afch/NixieClock/Schematic NCT318 v1.0.pdf

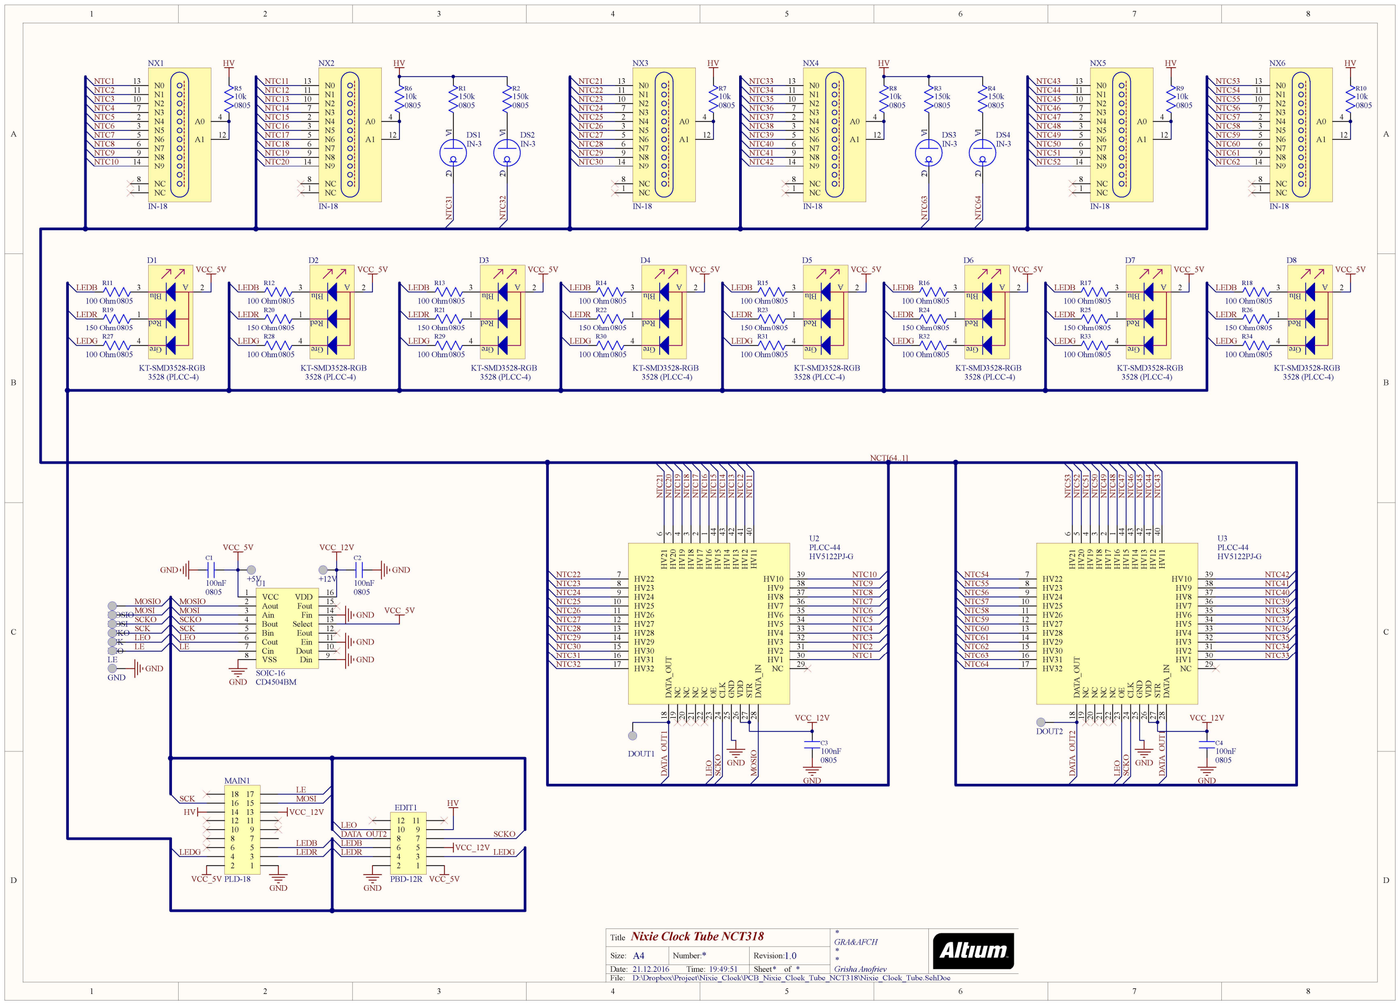
[picture p3: page 1]

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
GRA&AFCH
*
*
* | Grisha Anofriev

## Nixie Clock Tube NCT318

* | 1.0
21.12.2016 19:49:51
D:\Dropbox\Project\Nixie_Clock\PCB_Nixie_Clock_Tube_NCT318\Nixie_Clock_Tube.SchDoc

Title

Size: | Number:
Date:
File:

Revision:
Time: | Sheet | of

A4

IN-3 ¹ 2 A C | DS1
IN-3 ¹ 2 A C | DS2

150k
0805

R1
150k
0805

R2

100 Ohm0805

R11

150 Ohm0805

R19

100 Ohm0805

R27

IN-18

NC 1

N1 11
N2 10
N3 7
N4 2
N5 3
N6 5
N7 6
N8 9
N9 14

N0 13

A0 | 4
A1 | 12

NC 8

NX1

GND

VCC_5V

NTC1
NTC2
NTC3
NTC4
NTC5
NTC6
NTC7
NTC8
NTC9
NTC10

VCC_5V

LEDB

LEDR

LEDG | NTC³¹ | NTC³² IN-18

NC 1

N1 11
N2 10
N3 7
N4 2
N5 3
N6 5
N7 6
N8 9
N9 14

N0 13

A0 | 4
A1 | 12

NC 8

NX2

NTC11
NTC12
NTC13
NTC14
NTC15
NTC16
NTC17
NTC18
NTC19
NTC20

LEDG

LEDB
LEDR

IN-18

NC 1

N1 11
N2 10
N3 7
N4 2
N5 3
N6 5
N7 6
N8 9
N9 14

N0 13

A0 | 4
A1 | 12

NC 8

NX3

NTC21
NTC22
NTC23
NTC24
NTC25
NTC26
NTC27
NTC28
NTC29
NTC30

IN-18

NC 1

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

N0 13

A0 | 4
A1 | 12

NC 8

NX4

NTC33
NTC34
NTC35

NTC42

NTC36
NTC37
NTC38
NTC39
NTC40
NTC41

IN-18

NC 1

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

N0 13

A0 | 4
A1 | 12

NC 8

NX5

NTC43
NTC44
NTC45
NTC46
NTC47
NTC48
NTC49
NTC50
NTC51
NTC52

IN-18

NC 1

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

N0 13

A0 | 4
A1 | 12

NC 8

NX6

NTC53
NTC54
NTC55
NTC56
NTC57
NTC58
NTC59
NTC60
NTC61
NTC62

PLD-18

2 1

4 3

6 5

8 7

10 9

12 11

14

16

18

13

15

17

MAIN1

3528 (PLCC-4)

2

1

KT-SMD3528-RGB

3

4 | Red Blu Gre | A

D1

100 Ohm0805

R12

150 Ohm0805

R20

100 Ohm0805

R28

VCC_5V

LEDB

LEDR

LEDG

3528 (PLCC-4)

2

1

KT-SMD3528-RGB

3

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
HV30 15
HV31 16
HV32 17 | HV¹¹ ⁴⁰ HV¹² ⁴¹ HV¹³ ⁴² HV¹⁴ ⁴³ HV¹⁵ ⁴⁴ OE 23 CLK 24 GND 25 VDD 26 STR 27 DATA_IN 28 DATA_OUT 18 NC 19 NC 20 NC 21 NC 22
NC | 29 HV1 | 30 HV2 | 31 HV3 | 32 HV4 | 33 HV5 | 34 HV6 | 35 HV7 | 36 HV8 | 37 HV9 | 38 HV10 | 39

U3

DOUT1
GND
NTC3 | LEO | DATA_OUT¹ GND DATA_OUT²
