afch/NixieClock/Schematic_Tubes_Board_NCT414_v1.0.pdf

## Hour

## Hour

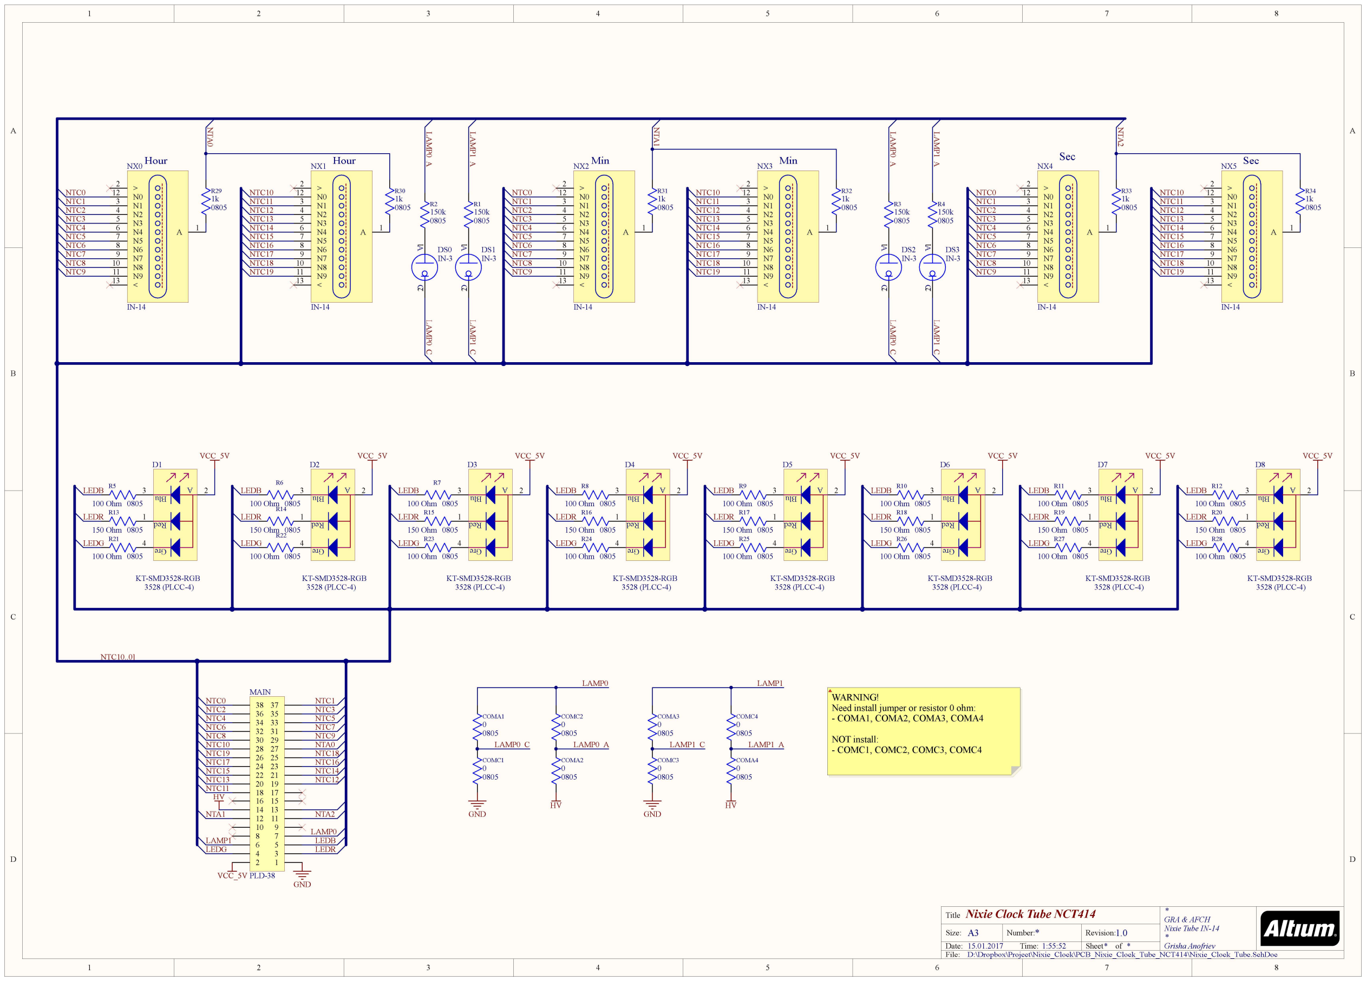
[picture p4: page 1]

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
GRA & AFCH
Nixie Tube IN-14
*
* | Grisha Anofriev

## Nixie Clock Tube NCT414

* | 1.0
15.01.2017 1:55:52
D:\Dropbox\Project\Nixie_Clock\PCB_Nixie_Clock_Tube_NCT414\Nixie_Clock_Tube.SchDoc

Title

Size: | Number:
Date:
File:

Revision:
Time: | Sheet | of

A3

IN-3 ¹ 2 A C | DS1
IN-3 ¹ 2 A C | DS0

150k
0805

R1
150k
0805

R2

GND

VCC_5V

NTC1
NTC2
NTC3
NTC4
NTC5
NTC6
NTC7
NTC8
NTC9 | NTA0 | LAMP0_A | LAMP1_A

VCC_5V

LEDR

LEDG

NTC2
NTC4
NTC6
NTC8
NTC0 | NTC1 NTC3 NTC5 NTC7 NTC9 NTA0

NTA1

LAMP1
LEDG

NTA2

LEDB
LEDR

LAMP0

NTC10

IN-14

>

2

N1 3
N2 4
N3 5
N4 6
N5 7
N6 8
N7 9
N8 10
N9 11

N0 12

A

1

<

13

NX0

NTC11
NTC12
NTC13
NTC14
NTC15
NTC16
NTC17
NTC18
NTC19 | NTA1

IN-14

>

2

N1 3
N2 4
N3 5
N4 6
N5 7
N6 8
N7 9
N8 10
N9 11

N0 12

A

1

<

13

NX1

NTC10

IN-3 ¹ 2 A C | DS3
IN-3 ¹ 2 A C | DS2

150k
0805

R4
150k
0805
R3 LAMP0_A | LAMP1_AMin

IN-14

>

2

N1 3
N2 4
N3 5
N4 6
N5 7
N6 8
N7 9
N8 10
N9 11

N0 12

A

1

<

13

NX2 | Min

IN-14

>

2

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

N0 12

A

1

<

13

NX3

## Sec

IN-14

>

2

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

N0 12

A

1

<

13

NX4 | Sec

IN-14

>

2

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

N0 12

A

1

<

13

NX5

100 Ohm 0805

R5

150 Ohm 0805

R13

100 Ohm 0805

R21

VCC_5V

LEDR

LEDG

100 Ohm 0805

R8

150 Ohm 0805

R16

100 Ohm 0805

R24

VCC_5V

LEDR

LEDG

100 Ohm 0805

R7

150 Ohm 0805

R15

100 Ohm 0805

R23

VCC_5V

LEDR

LEDG

100 Ohm 0805

R10

150 Ohm 0805

R18

100 Ohm 0805

R26

VCC_5V

LEDR

LEDG

100 Ohm 0805

R9

150 Ohm 0805

R17

100 Ohm 0805

R25

VCC_5V

LEDR

LEDG

100 Ohm 0805

R12

150 Ohm 0805

R20

100 Ohm 0805

R28

VCC_5V

LEDR

LEDG

100 Ohm 0805

R11

150 Ohm 0805

R19

100 Ohm 0805

R27

VCC_5V

LEDR

LEDG

NTC10..0] | NTA2
LEDB | LEDB | LEDB | LEDB | LEDB | LEDB | LEDB | LEDB
| 100 Ohm 0805

R6

150 Ohm 0805

R14

100 Ohm 0805

R22

2 1

4 3

6 5

8 7

10 9

12 11

14 13

16 15

18 17

20 19

22 21

24 23

26 25

28 27

30 29

32 31

34 33

36 35

38 37

PLD-38

MAIN

NTC19
NTC17
NTC15
NTC13
NTC11

NTC12

NTC14

NTC16

NTC18

1k
0805

R29
1k
0805

R30
1k
0805

R31
1k
0805

R32
1k
0805

R33
1k
0805
NTC0 | R34
NTC1
NTC2
NTC3
NTC4
NTC5
NTC6
NTC7
NTC8
NTC9

NTC0

3528 (PLCC-4)

2

1

KT-SMD3528-RGB

3

4 | Red Blu Gre | A

D1

3528 (PLCC-4)

2

1

KT-SMD3528-RGB

3

4 | Red Blu Gre | A

D2

3528 (PLCC-4)

2

1

KT-SMD3528-RGB

3

4 | Red Blu Gre | A

D3

3528 (PLCC-4)

2

1

KT-SMD3528-RGB

3

4 | Red Blu Gre | A

D4

3528 (PLCC-4)

2

1

KT-SMD3528-RGB

3

4 | Red Blu Gre | A

D5

3528 (PLCC-4)

2

1

KT-SMD3528-RGB

3

4 | Red Blu Gre | A

D6

3528 (PLCC-4)

2

1

KT-SMD3528-RGB

3

4 | Red Blu Gre | A

D7

3528 (PLCC-4)

2

1

KT-SMD3528-RGB

3

4 | Red Blu Gre | A

D8

NTC11
NTC12
NTC13
NTC14
NTC15
NTC16
NTC17
NTC18
NTC19

NTC10
NTC11
NTC12
NTC13
NTC14
NTC15
NTC16
NTC17
NTC18
NTC19

NTC10
NTC1
NTC2
NTC3
NTC4
NTC5
NTC6
NTC7
NTC8
NTC9

NTC0

HV

0
0805

COMA2

0
0805

COMC2

0
0805

COMC1

0
0805

COMA1

LAMP0_C | LAMP0_A

HV

LAMP0

GND

0
0805

COMA4

0
0805

COMC4

0
0805

COMC3

0
0805

COMA3

LAMP1_C | LAMP1_A

HV

LAMP1

GND LAMP0_C | LAMP1_C | LAMP0_C | LAMP1_C

### WARNING! Need install jumper or resistor 0 ohm: - COMA1, COMA2, COMA3, COMA4

### NOT install: - COMC1, COMC2, COMC3, COMC4
