afch/NixieClock/Schemes/Scheme Tubes Board - NCT482 v1.0.pdf

## Hour

## Hour

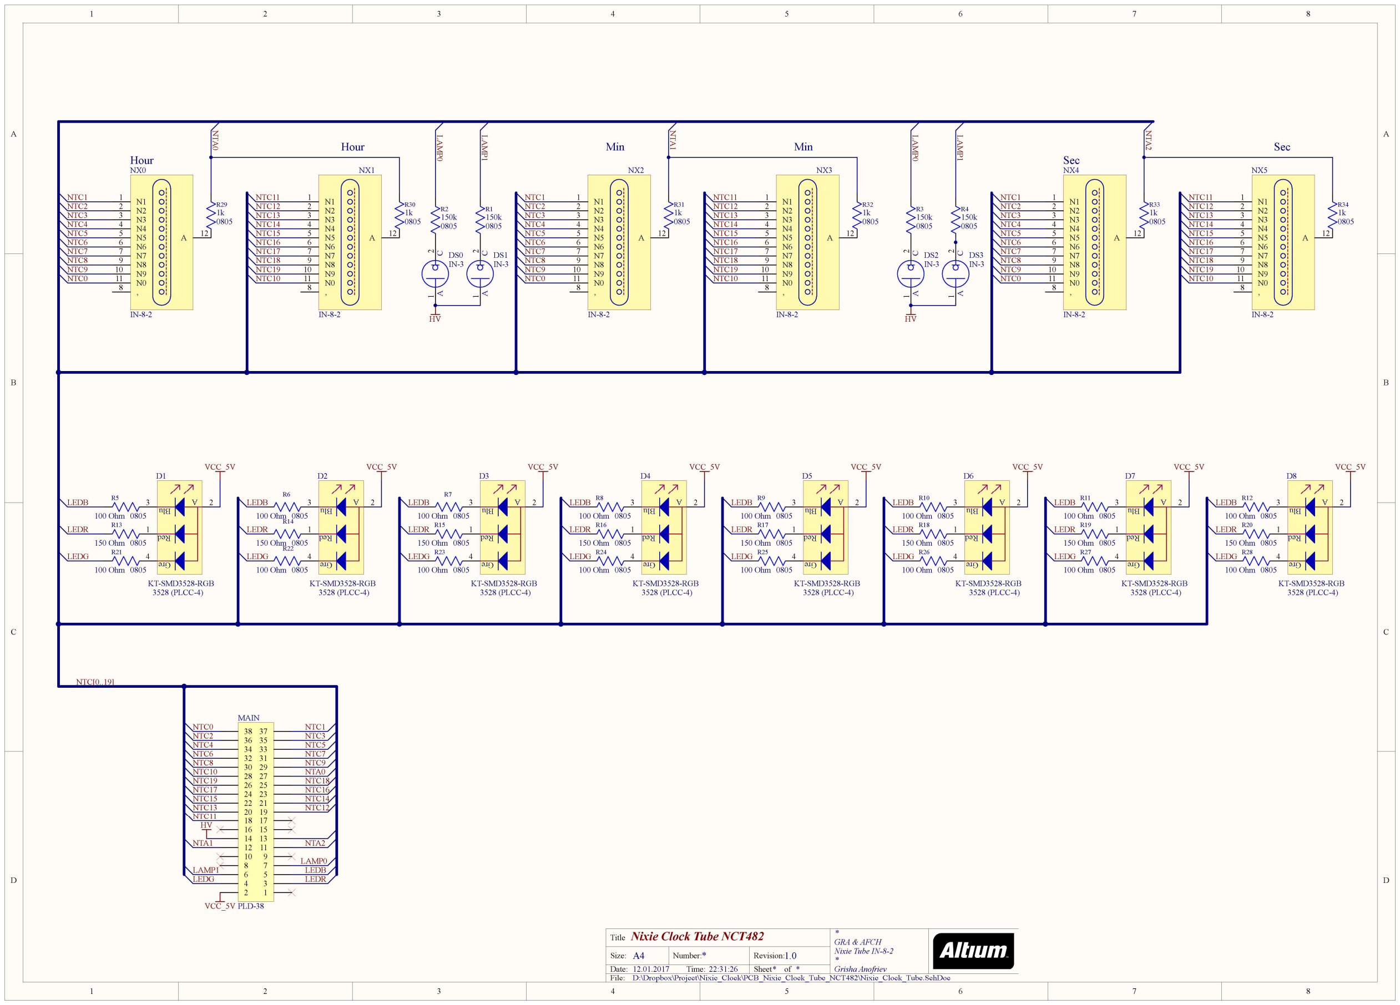
[picture p6: page 1]

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
GRA & AFCH
Nixie Tube IN-8-2
*
* | Grisha Anofriev

## Nixie Clock Tube NCT482

* | 1.0
12.01.2017 22:31:26
D:\Dropbox\Project\Nixie_Clock\PCB_Nixie_Clock_Tube_NCT482\Nixie_Clock_Tube.SchDoc

Title

Size: | Number:
Date:
File:

Revision:
Time: | Sheet | of

A4

IN-3 1 2 A CDS1

IN-3 1 2 A CDS0

150k
0805

R1
150k
0805

R2

NTC1
NTC2
NTC3
NTC4
NTC5
NTC6
NTC7
NTC8
NTC9
NTC0 | NTA0 | LAMP0 | LAMP1

VCC_5V

LEDR

LEDG

NTC11
NTC12
NTC13
NTC14
NTC15
NTC16
NTC17
NTC18
NTC19 | NTA1

IN-3 1 2 A CDS3

IN-3 1 2 A CDS2

150k
0805

R4
150k
0805

R3

NTC1
NTC2
NTC3
NTC4
NTC5
NTC6
NTC7
NTC8
NTC9
NTC0 | LAMP0 | LAMP1 Min | Min

NTC1
NTC2
NTC3
NTC4
NTC5
NTC6
NTC7
NTC8
NTC9
NTC0

## Sec

## Sec

100 Ohm 0805

R5

150 Ohm 0805

R13

100 Ohm 0805

R21

VCC_5V

LEDR

LEDG

100 Ohm 0805

R8

150 Ohm 0805

R16

100 Ohm 0805

R24

VCC_5V

LEDR

LEDG

100 Ohm 0805

R7

150 Ohm 0805

R15

100 Ohm 0805

R23

VCC_5V

LEDR

LEDG

100 Ohm 0805

R10

150 Ohm 0805

R18

100 Ohm 0805

R26

VCC_5V

LEDR

LEDG

100 Ohm 0805

R9

150 Ohm 0805

R17

100 Ohm 0805

R25

VCC_5V

LEDR

LEDG

100 Ohm 0805

R12

150 Ohm 0805

R20

100 Ohm 0805

R28

VCC_5V

LEDR

LEDG

100 Ohm 0805

R11

150 Ohm 0805

R19

100 Ohm 0805

R27

VCC_5V

LEDR

LEDG | NTA2
LEDB | LEDB | LEDB | LEDB | LEDB | LEDB | LEDB | LEDB
| 100 Ohm 0805

R6

150 Ohm 0805

R14

100 Ohm 0805

R22

3528 (PLCC-4)

2

1

KT-SMD3528-RGB

3

4 | Red Blu Gre | A

D1

3528 (PLCC-4)

2

1

KT-SMD3528-RGB

3

4 | Red Blu Gre | A

D2

3528 (PLCC-4)

2

1

KT-SMD3528-RGB

3

4 | Red Blu Gre | A

D3

3528 (PLCC-4)

2

1

KT-SMD3528-RGB

3

4 | Red Blu Gre | A

D4

3528 (PLCC-4)

2

1

KT-SMD3528-RGB

3

4 | Red Blu Gre | A

D8

3528 (PLCC-4)

2

1

KT-SMD3528-RGB

3

4 | Red Blu Gre | A

D7

3528 (PLCC-4)

2

1

KT-SMD3528-RGB

3

4 | Red Blu Gre | A

D6

3528 (PLCC-4)

2

1

KT-SMD3528-RGB

3

4 | Red Blu Gre | A

D5

N1 1
N2 2
N3 3
N4 4
N5 5
N6 6
N7 7
N8 9
N9 10
N0 11

A

12

IN-8-2

,

8

NX0

N1 1
N2 2
N3 3
N4 4
N5 5
N6 6
N7 7
N8 9
N9 10
N0 11

A

12

IN-8-2

,

8

NX5

N1 1
N2 2
N3 3
N4 4
N5 5
N6 6
N7 7
N8 9
N9 10
N0 11

A

12

IN-8-2

,

8

NX4

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

A

12

IN-8-2

,

8

NX3

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

A

12

IN-8-2

,

8

NX2

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

A

12

IN-8-2

,

8

NX1

NTC10

VCC_5V

NTC2
NTC4
NTC6
NTC8
NTC0 | NTC1 NTC3 NTC5 NTC7 NTC9 NTA0

NTA1

LAMP1
LEDG

NTA2

LEDB
LEDR

LAMP0

NTC10
NTC19
NTC17
NTC15
NTC13
NTC11

NTC12

NTC14

NTC16

NTC18

HV

1k
0805

R34
1k
0805

R33
1k
0805

R32
1k
0805

R31
1k
0805

R30
1k
0805

R29

HV | HV

NTC11
NTC12
NTC13
NTC14
NTC15
NTC16
NTC17
NTC18
NTC19
NTC10

NTC11
NTC12
NTC13
NTC14
NTC15
NTC16
NTC17
NTC18
NTC19
NTC10

2 1

4 3

6 5

8 7

10 9

12 11

14 13

16 15

18 17

20 19

22 21

24 23

26 25

28 27

30 29

32 31

34 33

36 35

38 37

PLD-38

MAIN

NTC[0..19]
