afch/NixieClock/Schemes/Scheme Nixie Clock Main Board MCU - NCM107 v1.1.pdf

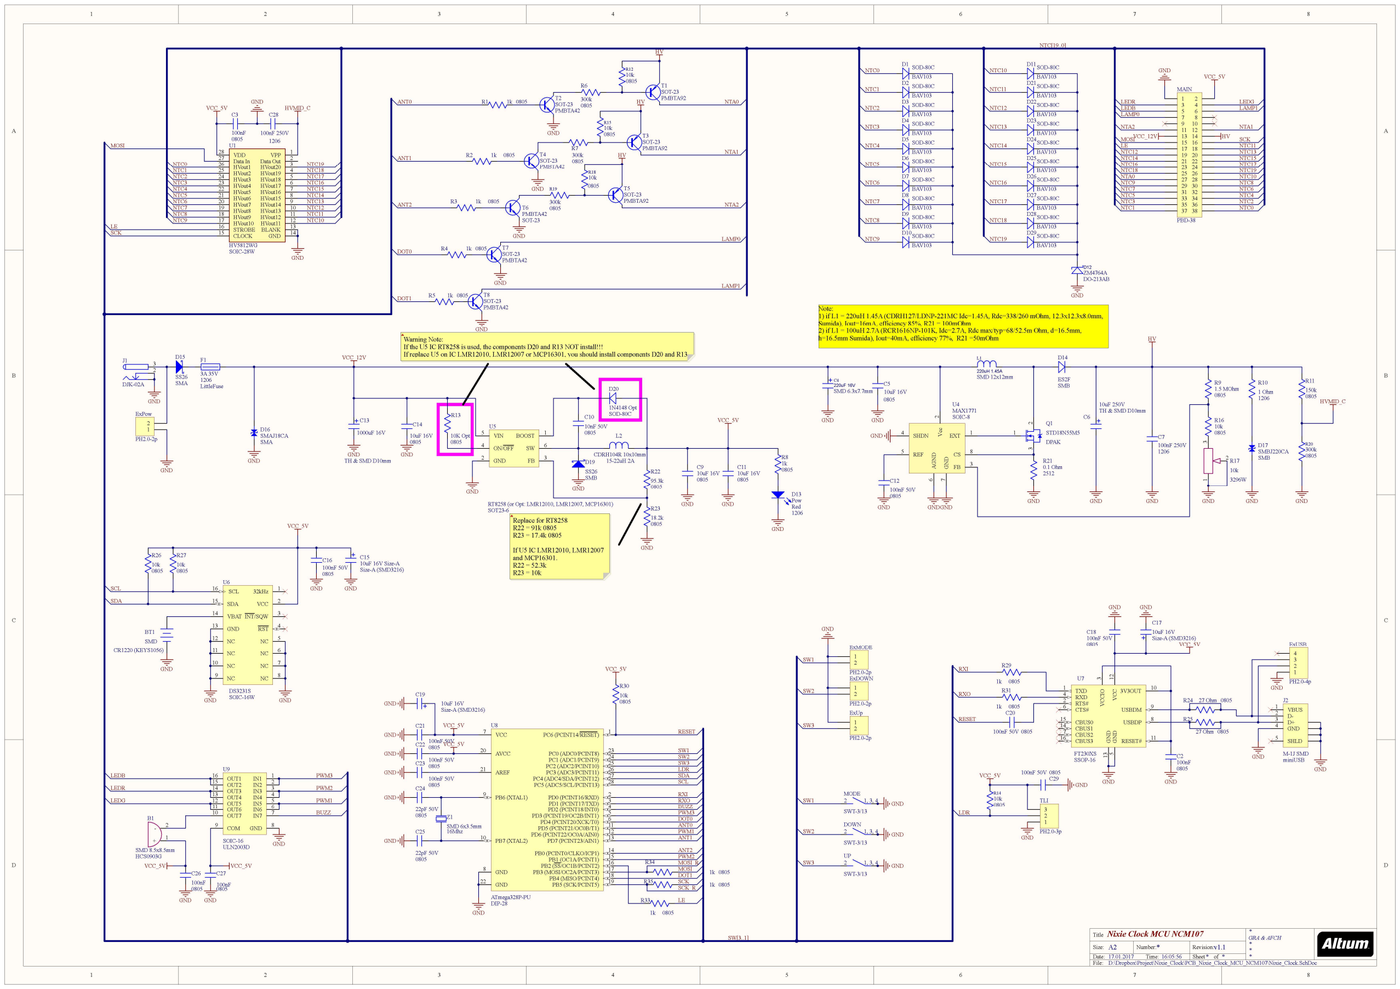
[picture p7: page 1]

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
GRA & AFCH
*
*
* | *

## Nixie Clock MCU NCM107

* | v1.1
17.01.2017 16:05:56
D:\Dropbox\Project\Nixie_Clock\PCB_Nixie_Clock_MCU_NCM107\Nixie_Clock.SchDoc

Title

Size: | Number:
Date:
File:

Revision:
Time: | Sheet | of

A2

Pow
Red
1206

D13

1k
0805

R8

GND

VCC_5V

GND

GND

95.3k
0805

R22

18.2k
0805

R23

GND

10nF 50V
0805

C10

GND

SS26
SMB

D19

GND

GND

10uF 16V
0805

C14

GND | GND

SOIC-8

SHDN 4

REF 5 | AGND

### 6 GND

7

FB | 3
CS | 8
EXT | 1 Vcc 2

MAX1771

U4

GNDGND

100nF 50V
0805

C12

GND

GND

ES2F
SMB

D14

100nF 250V
1206

C7

GND | GND

### 1.5 MOhm

0805

R9

10k
0805

R16

GND | GND

10uF 16V
0805

C5

GND

HVMID_C 1206

### 1 Ohm

R10

GND

300k
0805

R7

R1 | 1k 0805
R2 | 1k 0805
R3 | 1k 0805
R4 | 1k 0805
R5 | 1k 0805

100nF
0805

C3

SOIC-16
ULN2003D
IN1 | 1
IN2 | 2
IN3 | 3
IN4 | 4
IN5 | 5
IN6 | 6
IN7 | 7

OUT1 16

OUT3 14
OUT4 13
OUT5 12
OUT6 11
OUT7 10

OUT2 15

COM 9 | GND | 8

U9

SMD
CR1220 (KEYS1056)

BT1

M-1J SMD

VBUS 1
D- 2
D+ 3
GND 4

SHLD 5

miniUSB

J2

2 1, 3, 4

SWT-3/13

MODE

2 1, 3, 4

SWT-3/13

DOWN

2 1, 3, 4

SWT-3/13

UP

10k
0805

R26
10k
0805

R27

100nF 50V
0805

C16

100nF
0805

C27

100nF 50V
0805

C18

100nF
0805

C26

SMD 6x3.5mm
16Mhz

Z1

22pF 50V
0805

C24

22pF 50V
0805

C25

100nF 50V
0805

C21

100nF 50V
0805

C22

100nF 50V
0805

C23

10uF 16V
Size-A (SMD3216)
C19 | 10k
| 0805

R30

R24 27 Ohm 0805

### 27 Ohm 0805

R25

1k 0805

R29

1k 0805

R31

100nF 50V 0805

C20

10uF 16V
Size-A (SMD3216)

C17

VCC_5V

GND | GND

GND

GND

GND | GND
VCC_5V | VCC_5V

VCC_5V

VCC_5V

VCC_5V

VCC_5V

ATmega328P-PU
DIP-28
PC6 (PCINT14/RESET) | 1
PD0 (PCINT16/RXD) | 2
PD1 (PCINT17/TXD) | 3
PD2 (PCINT18/INT0) | 4
PD3 (PCINT19/OC2B/INT1) | 5
PD4 (PCINT20/XCK/T0) | 6

VCC 7

GND 8

PB6 (XTAL1) 9

PB7 (XTAL2) 10

PD5 (PCINT21/OC0B/T1) | 11
PD6 (PCINT22/OC0A/AIN0) | 12
PD7 (PCINT23/AIN1) | 13
PB0 (PCINT0/CLKO/ICP1) | 14
PB1 (OC1A/PCINT1) | 15
PB2 (SS/OC1B/PCINT2) | 16
PB3 (MOSI/OC2A/PCINT3) | 17
PB4 (MISO/PCINT4) | 18
PB5 (SCK/PCINT5) | 19

AVCC 20

AREF 21

GND 22

PC0 (ADC0/PCINT8) | 23
PC1 (ADC1/PCINT9) | 24
PC2 (ADC2/PCINT10) | 25
PC3 (ADC3/PCINT11) | 26
PC4 (ADC4/SDA/PCINT12) | 27
PC5 (ADC5/SCL/PCINT13) | 28

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
GND | GND

GND

GND

GND

GND

GND

GND

HVMID_C

GND

SCK

LE

MOSI

NTC6

NTC5

NTC4

NTC3

NTC2

NTC1

NTC0

NTA0

NTA1

NTA2

LAMP0

LAMP1

NTC0

NTC1

NTC2

NTC3

NTC4

NTC5

NTC6

NTC7

NTC8

NTC9

LEDR
LEDB
LAMP0

NTA2

NTA0
NTC9
NTC7
NTC5
NTC3
NTC1 | NTC0 NTC2

NTC4

NTC6

NTC8

NTC10

NTA1

LAMP1

LEDG

GND
VCC_5V

SW1

SW2

SW3

RXI

RXO

RESET

RESET

SW1
SW2

SDA
SCL

RXI
RXO
BUZZ
PWM3

ANT2

PWM1

LE

ANT0

PWM2

MOSI

SCK

PWM3

PWM2

PWM1

BUZZ

LEDB

LEDR

LEDG

SCL

SDA

NTC[19..0]

SW[3..1]

3296W

10k ³ 1

### 2 R17

10uF 16V Size-A
Size-A (SMD3216)

C15

GND

GND

GND

150k
0805

R11

SMBJ220CA
SMB

D17

1000uF 16V

TH & SMD D10mm

C13

10uF 250V
TH & SMD D10mm
C6

GND

100nF 250V
1206

C28

1k 0805

R33

1k 0805

R34

1k 0805 R35

MOSI_R

SCK_R

10uF 16V
0805

C9
10uF 16V
0805

C11

10K Opt
0805

R13

CDRH104R 10x10mm
15-22uH 2A

L2

1N4148 Opt
SOD-80C

D20

SW1

SW2

SW3

SMD 8.5x8.5mm
HCS0903G

+

1

2

B1

GND

FB | 3
VIN 5 | BOOST | 1

GND 2

SW 6 ON/OFF 4

RT8258 (or Opt: LMR12010, LMR12007, MCP16301) SOT23-6

U5

3A 35V
1206
LittleFuse

F1

### Note:

1) if L1 = 220uH 1.45A (CDRH127/LDNP-221MC Idc=1.45А, Rdc=338/260 mOhm, 12.3x12.3x8.0mm,

### Sumida), Iout=16mA, efficiency 85%, R21 = 100mOhm

2) if L1 = 100uH 2.7A (RCR1616NP-101K, Idc=2.7A, Rdc max/typ=68/52.5m Ohm, d=16.5mm,
h=16.5mm Sumida), Iout=40mA, efficiency 77%, R21 =50mOhm | VCC ¹² VCCIO

3
3V3OUT 10 GND

# 5 GND 13

USBDM | 9
USBDP | 8
RESET# | 11

TXD 1
RXD 4
RTS# 2
CTS# 6

CBUS0 15
CBUS1 14
CBUS2 7
CBUS3 16

FT230XS
SSOP-16

U7

100nF
0805

C2

GND

HV5812WG
SOIC-28W
VPP | 1
Data Out | 2
HVout20 | 3
HVout19 | 4
HVout18 | 5
HVout17 | 6
HVout16 | 7
HVout15 | 8
HVout14 | 9
HVout13 | 10
HVout12 | 11
HVout11 | 12
BLANK | 13
GND | 14 CLOCK 15 | STROBE 16 | HVout10 17 | HVout9 18 | HVout8 19 | HVout7 20 | HVout6 21 | HVout5 22 | HVout4 23 | HVout3 24

VDD 28
Data In 27
HVout1 26
HVout2 25

U1

SOD-80C
BAV103

D2

SS26
SMA

D15

SOD-80C
BAV103

D4

SOD-80C
BAV103

D6

SOD-80C
BAV103

D8

SOD-80C
BAV103

D10

SOD-80C
BAV103

D21

SOD-80C
BAV103

D23

SOD-80C
BAV103

D25

SOD-80C
BAV103

D27

SOD-80C
BAV103

D29

NTC10

NTC11

NTC12

NTC13

NTC14

NTC15

NTC16

NTC17

NTC18

NTC19

SOD-80C
BAV103

D1

SOD-80C
BAV103

D3

SOD-80C
BAV103

D5

SOD-80C
BAV103

D7

SOD-80C
BAV103

D9

SOD-80C
BAV103

D11

SOD-80C
BAV103

D22

SOD-80C
BAV103

D24

SOD-80C
BAV103

D26

SOD-80C
BAV103

D28

NTC11
NTC12 | NTC13
NTC14 | NTC15
NTC16 | NTC17
NTC18 | NTC19

NTC7
NTC8
NTC9

NTC19
NTC18
NTC17
NTC16
NTC15
NTC14
NTC13
NTC12
NTC11
NTC10

PH2.0-2p

1
2

ExUp

PH2.0-2p

1
2

ExDOWN

PH2.0-2p

1
2

ExMODE

GND

PH2.0-4p

1

2

3

4

ExUSB

PH2.0-2p

1

2

ExPow

GND

VCC_5V

HV

VCC_12V

VCC_12V MOSI
LE

SCK

220uF 16V
SMD 6.3x7.7mm

C4

ANT1

PH2.0-3p

1

2

3

TLI

GND

10k
0805

R14

VCC_5V

SW3
LDR

LDR

100nF 50V 0805
C29
GND
32kHz | 1
VCC | 2
INT/SQW | 3
RST | 4 GND 13

VBAT 14

SDA 15

SCL 16

NC | 5
NC | 6
NC | 7
NC | 8 NC 9

NC 10

NC 11

NC 12

DS3231S
SOIC-16W

U6

GND

SMAJ18CA
SMA

D16

DOT1

DOT0

GND

SOT-23
PMBTA42

T8

SOT-23
PMBTA42

T7

SOT-23

PMBTA42

T6

SOT-23
PMBTA42

T4

SOT-23
PMBTA42

T2

SOT-23
PMBTA92

T1

SOT-23
PMBTA92

T3

SOT-23
PMBTA92

T5

GND

GND

300k
0805

R6

GND

GND

300k
0805

R19

10k
0805

R12

10k
0805

R15

10k
0805

R18

HV

HV

ANT0

ANT1

ANT2

DOT0

DOT1

ZM4764A
DO-213AB

D12

### 0.1 Ohm

2512

R21

STD18N55M5

DPAK ²
1 3

Q1

220uH 1.45A
SMD 12x12mm

L1

1 2
3 4
5 6
7 8
9 10
11 12
13 14
15 16
17 18
19 20
21 22
23 24
25 26
27 28
29 30
31 32
33 34
35 36
37 38
PBD-38

MAIN

3

1

2

DJK-02A

J1

300k
0805

R20

### Replace for RT8258

R22 = 91k 0805
R23 = 17.4k 0805

### If U5 IC LMR12010, LMR12007

and MCP16301.
R22 = 52.3k
R23 = 10k

### Warning Note: If the U5 IC RT8258 is used, the components D20 and R13 NOT install!!!

If replace U5 on IC LMR12010, LMR12007 or MCP16301, you should install components D20 and R13
