afch/NixieClock/Firmwares/MCU Board NCM109 v1.x for Tubes board NCT3xx (8 tubes)_1K/Source Code/CountDownTimerNCT818/Readme.txt

Задумка такая:
Формат: hh:hh:mm:ss
Mode - длинное нажатие вход в режим установки, короткое нажатие переход на следующию цифру, дошли дальше послендей - выход.
Mode - короткие нажатия start/stop
UP/DOWN - в режиме установки увеличивает по одной цифре (каждую индивидуально)

Каждая цифра свой элемент массива
