afch/NixieClock/Schemes/Previous Versions/Scheme Nixie Clock Main Board MCU - NCM105 v1.6.pdf

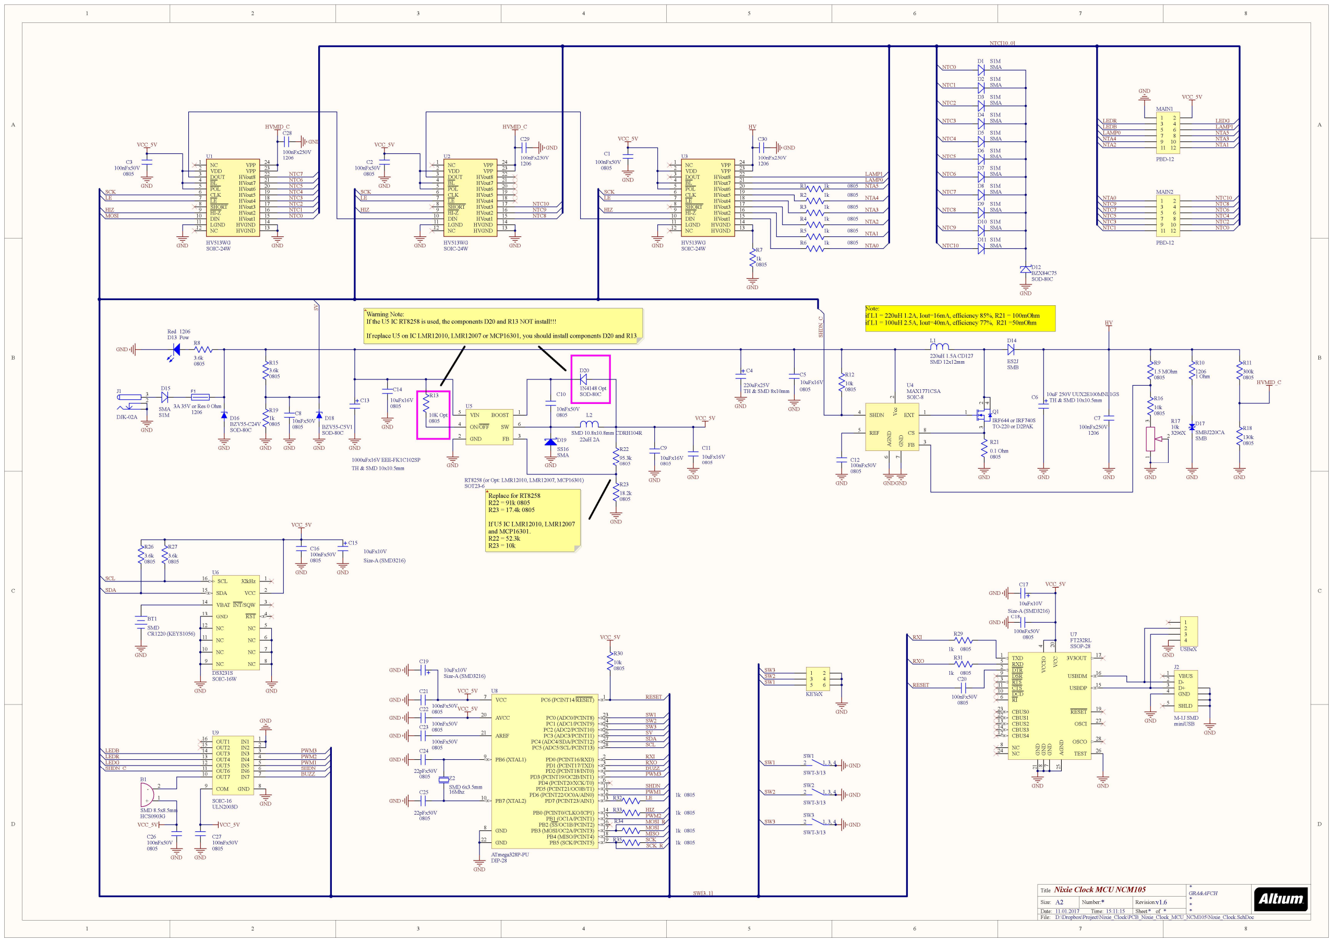
[picture p8: page 1]

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
GRA&AFCH
*
*
* | *

## Nixie Clock MCU NCM105

* | v1.6
11.01.2017 15:11:15
D:\Dropbox\Project\Nixie_Clock\PCB_Nixie_Clock_MCU_NCM105\Nixie_Clock.SchDoc

Title

Size: | Number:
Date:
File:

Revision:
Time: | Sheet | of

A2

3

1

2

DJK-02A

J1

SMA
S1M

D15

Pow

Red 1206
D13

3.6k
0805

R8
GND

VCC_5V
BZV55-C24V
SOD-80C

D16

GND | GND 1k
| 0805

R19

3.6k
0805

R15

10nFx50V
0805

C8

BZV55-C5V1
SOD-80C

D18

GND | GND

GND

95.3k
0805

R22

18.2k
0805

R23

GND

10nFx50V
0805

C10

GND

SS16
SMA

D19

GND

GND

10uFx16V
0805

C14

GND

GND

SOIC-8

SHDN 4

REF 5 | AGND

### 6 GND

7

FB | 3
CS | 8
EXT | 1 Vcc 2

MAX1771CSA

U4 10k
0805

R12

GNDGND

100nFx50V
0805

C12

GND

### 0.1 Ohm

0805

R21

IRF644 or IRF740S

TO-220 or D2PAK ²
1 3

4
Q1

GND

220uH 1.5A CD127
SMD 12x12mm

L1

ES2J
SMB

D14

100nFx250V
1206

C7

GND | GND

### 1.5 MOhm

0805

R9

10k
0805

R16

GND | GND

10uFx16V
0805

C5

GND

HVMID_C

1206

### 1 Ohm

R10

GND

HV513WG
SOIC-24W

NC 1
VDD 2
DOUT 3
BL 4
POL 5
CLK 6
LE 7
SHORT 8
HI-Z 9
DIN 10
LGND 11
NC 12 | HVGND | 13 HVGND | 14 HVout1 | 15 HVout2 | 16 HVout3 | 17 HVout4 | 18 HVout5 | 19 HVout6 | 20 HVout7 | 21 HVout8 | 22 VPP | 23 VPP | 24

U1

HV513WG
SOIC-24W

NC 1
VDD 2
DOUT 3
BL 4
POL 5
CLK 6
LE 7
SHORT 8
HI-Z 9
DIN 10
LGND 11
NC 12 | HVGND | 13 HVGND | 14 HVout1 | 15 HVout2 | 16 HVout3 | 17 HVout4 | 18 HVout5 | 19 HVout6 | 20 HVout7 | 21 HVout8 | 22 VPP | 23 VPP | 24

U2

HV513WG
SOIC-24W

NC 1
VDD 2
DOUT 3
BL 4
POL 5
CLK 6
LE 7
SHORT 8
HI-Z 9
DIN 10
LGND 11
NC 12 | HVGND | 13 HVGND | 14 HVout1 | 15 HVout2 | 16 HVout3 | 17 HVout4 | 18 HVout5 | 19 HVout6 | 20 HVout7 | 21 HVout8 | 22 VPP | 23 VPP | 24

U3

BZX84C75
SOD-80C

D12

1 2
3 4
5 6
7 8
9 10
11 12

PBD-12

MAIN2

1 2
3 4
5 6
7 8
9 10
11 12

PBD-12

MAIN1

1k
0805

R7

R1 | 1k | 0805
R2 | 1k | 0805
R3 | 1k | 0805
R4 | 1k | 0805
R5 | 1k | 0805
R6 | 1k | 0805

100nFx50V
0805

C1

100nFx50V
0805

C2
100nFx50V
0805

C3

SOIC-16
ULN2003D
IN1 | 1
IN2 | 2
IN3 | 3
IN4 | 4
IN5 | 5
IN6 | 6
IN7 | 7

OUT1 16

OUT3 14
OUT4 13
OUT5 12
OUT6 11
OUT7 10

OUT2 15

COM 9 | GND | 8

U9

SMD
CR1220 (KEYS1056)

BT1

FT232RL
SSOP-28
NC 24 | NC 8 | VCCIO

4

RXD 5

RI 6 | GND

7

DSR 9

DCD 10 CTS 11

CBUS4 12

CBUS2 13
CBUS3 14
USBDP | 15
USBDM | 16
3V3OUT | 17 GND 18
RESET | 19 VCC ²⁰ GND 21
CBUS1 22 | CBUS0 23 | AGND 25
TEST | 26
OSCI | 27
OSCO | 28

TXD 1

DTR 2

RTS 3

U7

M-1J SMD

VBUS 1
D- 2
D+ 3
GND 4

SHLD 5

miniUSB

J2

2 1, 3, 4

SWT-3/13

SW1

2 1, 3, 4

SWT-3/13

SW2

2 1, 3, 4

SWT-3/13

SW3

3.6k
0805

R26
3.6k
0805

R27

100nFx50V
0805

C27

100nFx50V
0805

C18

100nFx50V
0805

C26

SMD 6x3.5mm
16Mhz

Z2

22pFx50V
0805

C24

22pFx50V
0805

C25

100nFx50V
0805

C21

100nFx50V
0805

C22

100nFx50V
0805

C23

10uFx10V
Size-A (SMD3216)
C19 | 10k
| 0805

R30

1k 0805

R29

1k 0805

R31

100nFx50V
0805

C20

10uFx10V
Size-A (SMD3216)

C17

GND

GND | GND
VCC_5V | VCC_5V

VCC_5V

VCC_5V

VCC_5V

VCC_5V

VCC_5V
VCC_5V | VCC_5V

ATmega328P-PU
DIP-28
PC6 (PCINT14/RESET) | 1
PD0 (PCINT16/RXD) | 2
PD1 (PCINT17/TXD) | 3
PD2 (PCINT18/INT0) | 4
PD3 (PCINT19/OC2B/INT1) | 5
PD4 (PCINT20/XCK/T0) | 6

VCC 7

GND 8

PB6 (XTAL1) 9

PB7 (XTAL2) 10

PD5 (PCINT21/OC0B/T1) | 11
PD6 (PCINT22/OC0A/AIN0) | 12
PD7 (PCINT23/AIN1) | 13
PB0 (PCINT0/CLKO/ICP1) | 14
PB1 (OC1A/PCINT1) | 15
PB2 (SS/OC1B/PCINT2) | 16
PB3 (MOSI/OC2A/PCINT3) | 17
PB4 (MISO/PCINT4) | 18
PB5 (SCK/PCINT5) | 19

AVCC 20

AREF 21

GND 22

PC0 (ADC0/PCINT8) | 23
PC1 (ADC1/PCINT9) | 24
PC2 (ADC2/PCINT10) | 25
PC3 (ADC3/PCINT11) | 26
PC4 (ADC4/SDA/PCINT12) | 27
PC5 (ADC5/SCL/PCINT13) | 28

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
GND | GND

GND

HVMID_C | HVMID_C
GND | GND

GND

GND

GND

SMA

D1 S1M

SMA

D2 S1M

SMA

D3 S1M

SMA

D4 S1M

SMA

D5 S1M

SMA

D6 S1M

SMA

D7 S1M

SMA

D8 S1M

SMA

D9 S1M

SMA

D10 S1M

GND

SCK
LE

HIZ
MOSI

SCK
LE

HIZ

NTC7
NTC6
NTC5
NTC4
NTC3
NTC2
NTC1
NTC0 | NTC8 NTC9

NTC10

SCK
LE

HIZ

NTA0

NTA1

NTA2

NTA3

NTA4

NTA5

LAMP0

LAMP1

NTC0

NTC1

NTC2

NTC3

NTC4

NTC5

NTC6

NTC7

NTC8

NTC9

SMA

D11 S1M
NTC10

LEDR
LEDB
LAMP0
NTA4
NTA2

NTA0
NTC9
NTC7
NTC5
NTC3
NTC1 | NTC0 NTC2

NTC4

NTC6

NTC8

NTC10

NTA1

NTA3

NTA5

LAMP1

LEDG

GND
VCC_5V SHDN_C SV

SW1

SW2

SW3

RXI

RXO

RESET

RESET

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
BUZZ
PWM3

SHDN
PWM1
LE

HIZ
PWM2

MOSI
MISO
SCK

PWM3
PWM2
PWM1
SHDN
BUZZ

SHDN_C

LEDB
LEDR
LEDG

SCL

SDA

NTC[10..0]

SW[3..1]

3296X

10k ³ 1

2

R17

GND

GND

GND

GND

300k
0805

R11

130k
0805

R18
SMBJ220CA
SMB

D17

1000uFx16V EEE-FK1C102SP
TH & SMD 10x10.5mm

C13

10uF 250V UUX2E100MNL1GS
TH & SMD 10x10.5mm C6

220uFx25V
TH & SMD 8x10mm

C4

GND

100nFx250V
1206

C29

100nFx250V
1206

C30
GND | GND
100nFx250V
1206

C28

1k 0805 R32

1k 0805 R33

1k 0805

R34

1k 0805 R35

MOSI_R

SCK_R

10uFx16V
0805

C9
10uFx16V
0805

C11

10K Opt
0805

R13

SMD 10.8x10.8mm CDRH104R
22uH 2A

L2

1N4148 Opt
SOD-80C

D20

1 2
3 4
5 6
KEYeX

GND

SW3
SW2
SW1

SMD 8.5x8.5mm
HCS0903G

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
USBeX
GND
FB | 3
VIN 5 | BOOST | 1

GND 2

SW 6 ON/OFF 4

RT8258 (or Opt: LMR12010, LMR12007, MCP16301) SOT23-6

3A 35V or Res 0 Ohm | U5
1206

F1

### Note: if L1 = 220uH 1.2A, Iout=16mA, efficiency 85%, R21 = 100mOhm if L1 = 100uH 2.5A, Iout=40mA, efficiency 77%, R21 =50mOhm

32kHz | 1
VCC | 2
INT/SQW | 3
RST | 4 GND 13

VBAT 14

SDA 15

SCL 16

NC | 5
NC | 6
NC | 7
NC | 8 NC 9

NC 10

NC 11

NC 12

DS3231S
SOIC-16W

U6

GND | GND

100nFx50V
0805

C16

VCC_5V

GND | GND

10uFx10V
Size-A (SMD3216)

C15

### Replace for RT8258

R22 = 91k 0805
R23 = 17.4k 0805

### If U5 IC LMR12010, LMR12007

and MCP16301.
R22 = 52.3k
R23 = 10k

### Warning Note: If the U5 IC RT8258 is used, the components D20 and R13 NOT install!!!

If replace U5 on IC LMR12010, LMR12007 or MCP16301, you should install components D20 and R13
