afch/NixieClock/(threads)

Thread 1 (2017-03-29):

Please provide...

SebiTimeWaster, 2017-03-29:
...schematics for NCM107 v1.1 and NCT412 V1.0.

also in the source code there is a "DHVpin" specified but in all instances commented out, is this not usable (anymore) on the aforementioned boards?
the pin number for the DHVpin is now used for the first anode pin, is there a new pin that switches the HV line?

SebiTimeWaster, 2017-04-02:
For your interest: https://github.com/SebiTimeWaster/Slave-Nixie-Clock

If i could switch off the HV line it would be complete...

afch, 2017-04-06:
In this version SHDN input is grounded.
If You need to turn off all tubes, You need to send over SPI
  int blank=B00000000; <-for NCT318 tubes board
or
  int blank=B00000000; <- any others boards 4xx series
  SPI.transfer(blank);
  SPI.transfer(blank);
  SPI.transfer(blank);
  SPI.transfer(blank);
  SPI.transfer(blank);
  SPI.transfer(blank);
  SPI.transfer(blank);
  SPI.transfer(blank);

2017-04-03 0:55 GMT+03:00 TimeWaster <notifications@github.com>:

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

afch, 2017-04-06:
Very useful modifications!!!!!! Thank You!!!

2017-04-06 17:06 GMT+03:00 Alexej Fomin <fominalec@gmail.com>:

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

SebiTimeWaster, 2017-04-06:
too bad the pin is grounded. it felt only right to turn off HV while the clock is in standby to save some mA/µA.

i also just added a 3d printed stand to my repo, this could be also useful to other users of the IN-12 version, feel free to copy it (MIT license), i will add photos in a moment.

afch, 2017-04-06:
Thank You for stands, we will try it...
We work on new version of MCU board - NCM108 where this input will be
connected to microcontroller again.

2017-04-06 17:48 GMT+03:00 TimeWaster <notifications@github.com>:

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

SebiTimeWaster, 2017-04-06:
cool. if i would be asked to breathe a wish i would say bring the HV switch IC's to the NCT board and don't cycle through the tubes separately. (like you did on the aurdino shield) this would make the display brighter and you could dim it via software without producing flicker.

anyway, i would still be happy if you could provide schematics for NCM107 v1.1 and NCT412 V1.0.

afch, 2017-04-06:
??? HMMMM....????
On both our shields (NCS314 and NCS312) we use full static mode and don't
switching between tubes!!!

See shematics in attachments:

2017-04-06 18:19 GMT+03:00 TimeWaster <notifications@github.com>:

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

afch, 2017-04-06:
Scheme was added to github

2017-04-06 19:00 GMT+03:00 Alexej Fomin <fominalec@gmail.com>:

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

SebiTimeWaster, 2017-04-06:
but i dont have NCS314 or NCS312?

afch, 2017-04-06:
These shields only in blue color...

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

SebiTimeWaster, 2017-04-06:
here are finally the pictures of the stand:
https://github.com/SebiTimeWaster/Slave-Nixie-Clock/blob/master/Nixie.png
https://github.com/SebiTimeWaster/Slave-Nixie-Clock/blob/master/Nixie_Stand.png
feel free to use them.

SebiTimeWaster, 2017-04-06:
http://www.thingiverse.com/thing:2232491

afch, 2017-04-07:
On real photos this stands looks even more better!

2017-04-06 23:18 GMT+03:00 TimeWaster <notifications@github.com>:

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

Closed 2017-04-06.

Thread 2 (2020-02-08):

RGB colors is not working as expected

cotestatnt, 2020-02-08:
Hi, I bought one of your kits and works quite well except the fading between the different background colors.

I noticed that the Tone library is used which unfortunately interferes with PWM signals and in fact the blue channel is not modulated correctly but only works in on/off mode.

To solve, I modified the firmware using a library that does not use hardware timers and therefore leaves the PWM functioning unchanged on all channels.

It would also be very useful to add the possibility to set the maximum light intensity of the background color among the settings, because at the maximun is a little annoying.

GRA-AFCH, 2020-02-08:
Hi, what library are You using?

сб, 8 февр. 2020 г. в 15:09, Tolentino Cotesta <notifications@github.com>:

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

cotestatnt, 2020-02-08:
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

I'm using TimerFreeTone. The disadvantage of this library is the usage of delayMicroseconds() in the iplementation, but with this "slow" type application is not a big issues for me.

https://bitbucket.org/teckel12/arduino-timer-free-tone/downloads/

Thread 3 (2020-08-01):

Mode button not responding

RetroSteam, 2020-08-01:
I purchased the nixie clock for rpi a little over a year and a half ago, and am only now getting around to try and use it.

The user manual says to hold down the mode button to step through the modes and make changes.  However, no matter how long I hold it down, nothing ever happens.  Is there maybe a hard reset I could do to see if the behavior changes?

RetroSteam, 2020-08-01:
NCS314 v2.2 12/01/2018
original firmware

Thread 4 (2022-03-12):

NCM109 v1.x for Tubes board NCT4xx and HV5222

Fossdal, 2022-03-12:
I got an MCU Board NCM109 v1.x for Tubes board NCT4xx
and it has a HV5222. but the code is not working with this chip

SensoriumEmbedded, 2022-12-27:
"MCU Board NCM109 v1.x for Tubes board NCT4xx"  doesn't compile correctly.  Had to replace SPI_Init(); with SPI.begin();
After this mod it compiles and works correctly.

CDAJoe, 2023-03-20:
I found the issue during compiling. It is a line of code at line 220 stating SPI_Init where there is no code to call. I copied the Spi initialization from the sample code or codes from other boards for Spi to correct this.

CDAJoe, 2023-03-20:
my bad the line is at 280
delete the SPI_Init(); and copy the next into its place moving existing code down. This got my unit working
SPI.begin(); //
  SPI.setDataMode (SPI_MODE2); // Mode 2 SPI // судя по данным осциллографа нужно использовать этот режим
  SPI.setClockDivider(SPI_CLOCK_DIV8); // SCK = 16MHz/128= 125kHz
  //Serial.println(SPCR, BIN);
  //SPCR=B00111111;
  //Serial.println(SPCR, BIN);

Thread 5 (2022-12-27):

"MCU Board NCM109 v1.x for Tubes board NCT4xx" doesn't compile

SensoriumEmbedded, 2022-12-27:
"MCU Board NCM109 v1.x for Tubes board NCT4xx" doesn't compile correctly. Had to replace SPI_Init(); with SPI.begin();
After this mod it compiles and works correctly.

SensoriumEmbedded, 2022-12-27:
I take that back, it now compiles, but does not display correctly...

SensoriumEmbedded, 2022-12-27:
Had to add the correct SPI init line as well as the .begin()
    SPI.beginTransaction(SPISettings(2000000, LSBFIRST, SPI_MODE2));  //for HV5222, or...
    SPI.beginTransaction(SPISettings(2000000, MSBFIRST, SPI_MODE2));  //for HV5122
Now it compiles and works!

afch, 2023-03-21:
Fixed...

Closed 2023-03-21.
