afch/NixieClock/Schemes/Scheme Nixie Clock Main Board MCU - NCM109 v1.41.pdf

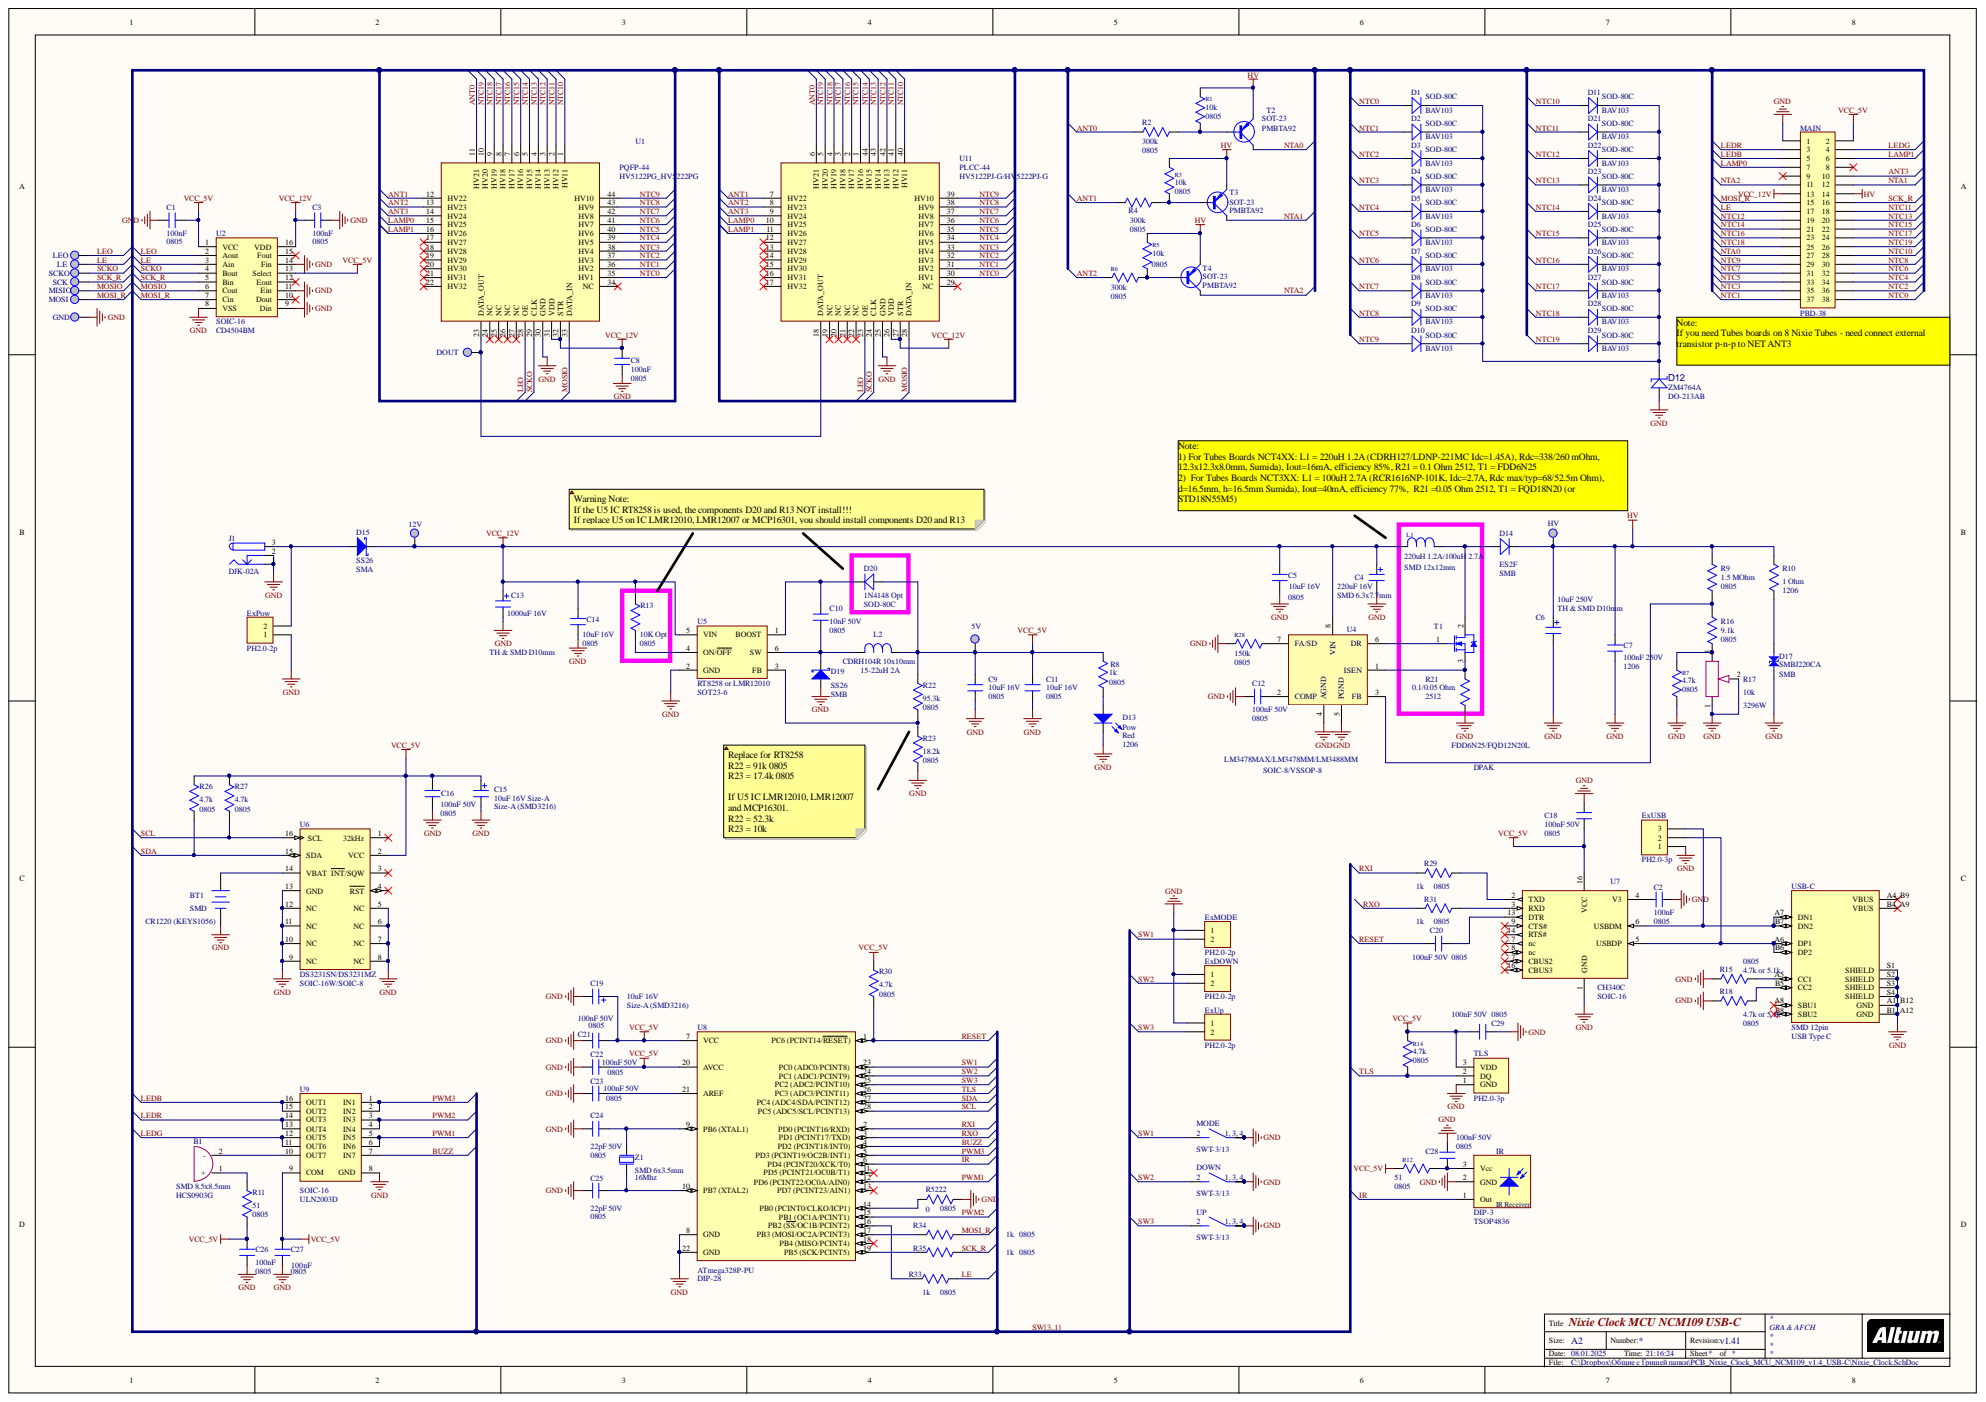
[picture p17: page 1]

Note:
If you need Tubes boards on 8 Nixie Tubes - need connect external
transistor p-n-p to NET ANT3

1) For Tubes Boards NCT4XX: L1 = 220uH 1.2A (CDRH127/LDNP-221MC Idc=1.45А), Rdc=338/260 mOhm,
12.3x12.3x8.0mm, Sumida), Iout=16mA, efficiency 85%, R21 = 0.1 Ohm 2512, T1 = FDD6N25
2) For Tubes Boards NCT3XX: L1 = 100uH 2.7A (RCR1616NP-101K, Idc=2.7A, Rdc max/typ=68/52.5m Ohm),
d=16.5mm, h=16.5mm Sumida), Iout=40mA, efficiency 77%, R21 =0.05 Ohm 2512, T1 = FQD18N20 (or
STD18N55M5)

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

Nixie Clock MCU NCM109 USB-C Title | * GRA & AFCH * * *

Size: A2 | Number: * | Revision: v1.41

Date: 08.01.2025 Time: 21:16:24 | | Sheet * of *

C:\Dropbox\Общие с Гришей папки\PCB_Nixie_Clock_MCU_NCM109_v1.4_USB-C\Nixie_Clock.SchDoc
