afch/NixieClock/Schemes/Scheme Tubes Board - NCT412 v1.0.pdf

Hour | Hour
Min | Min | Sec | Sec

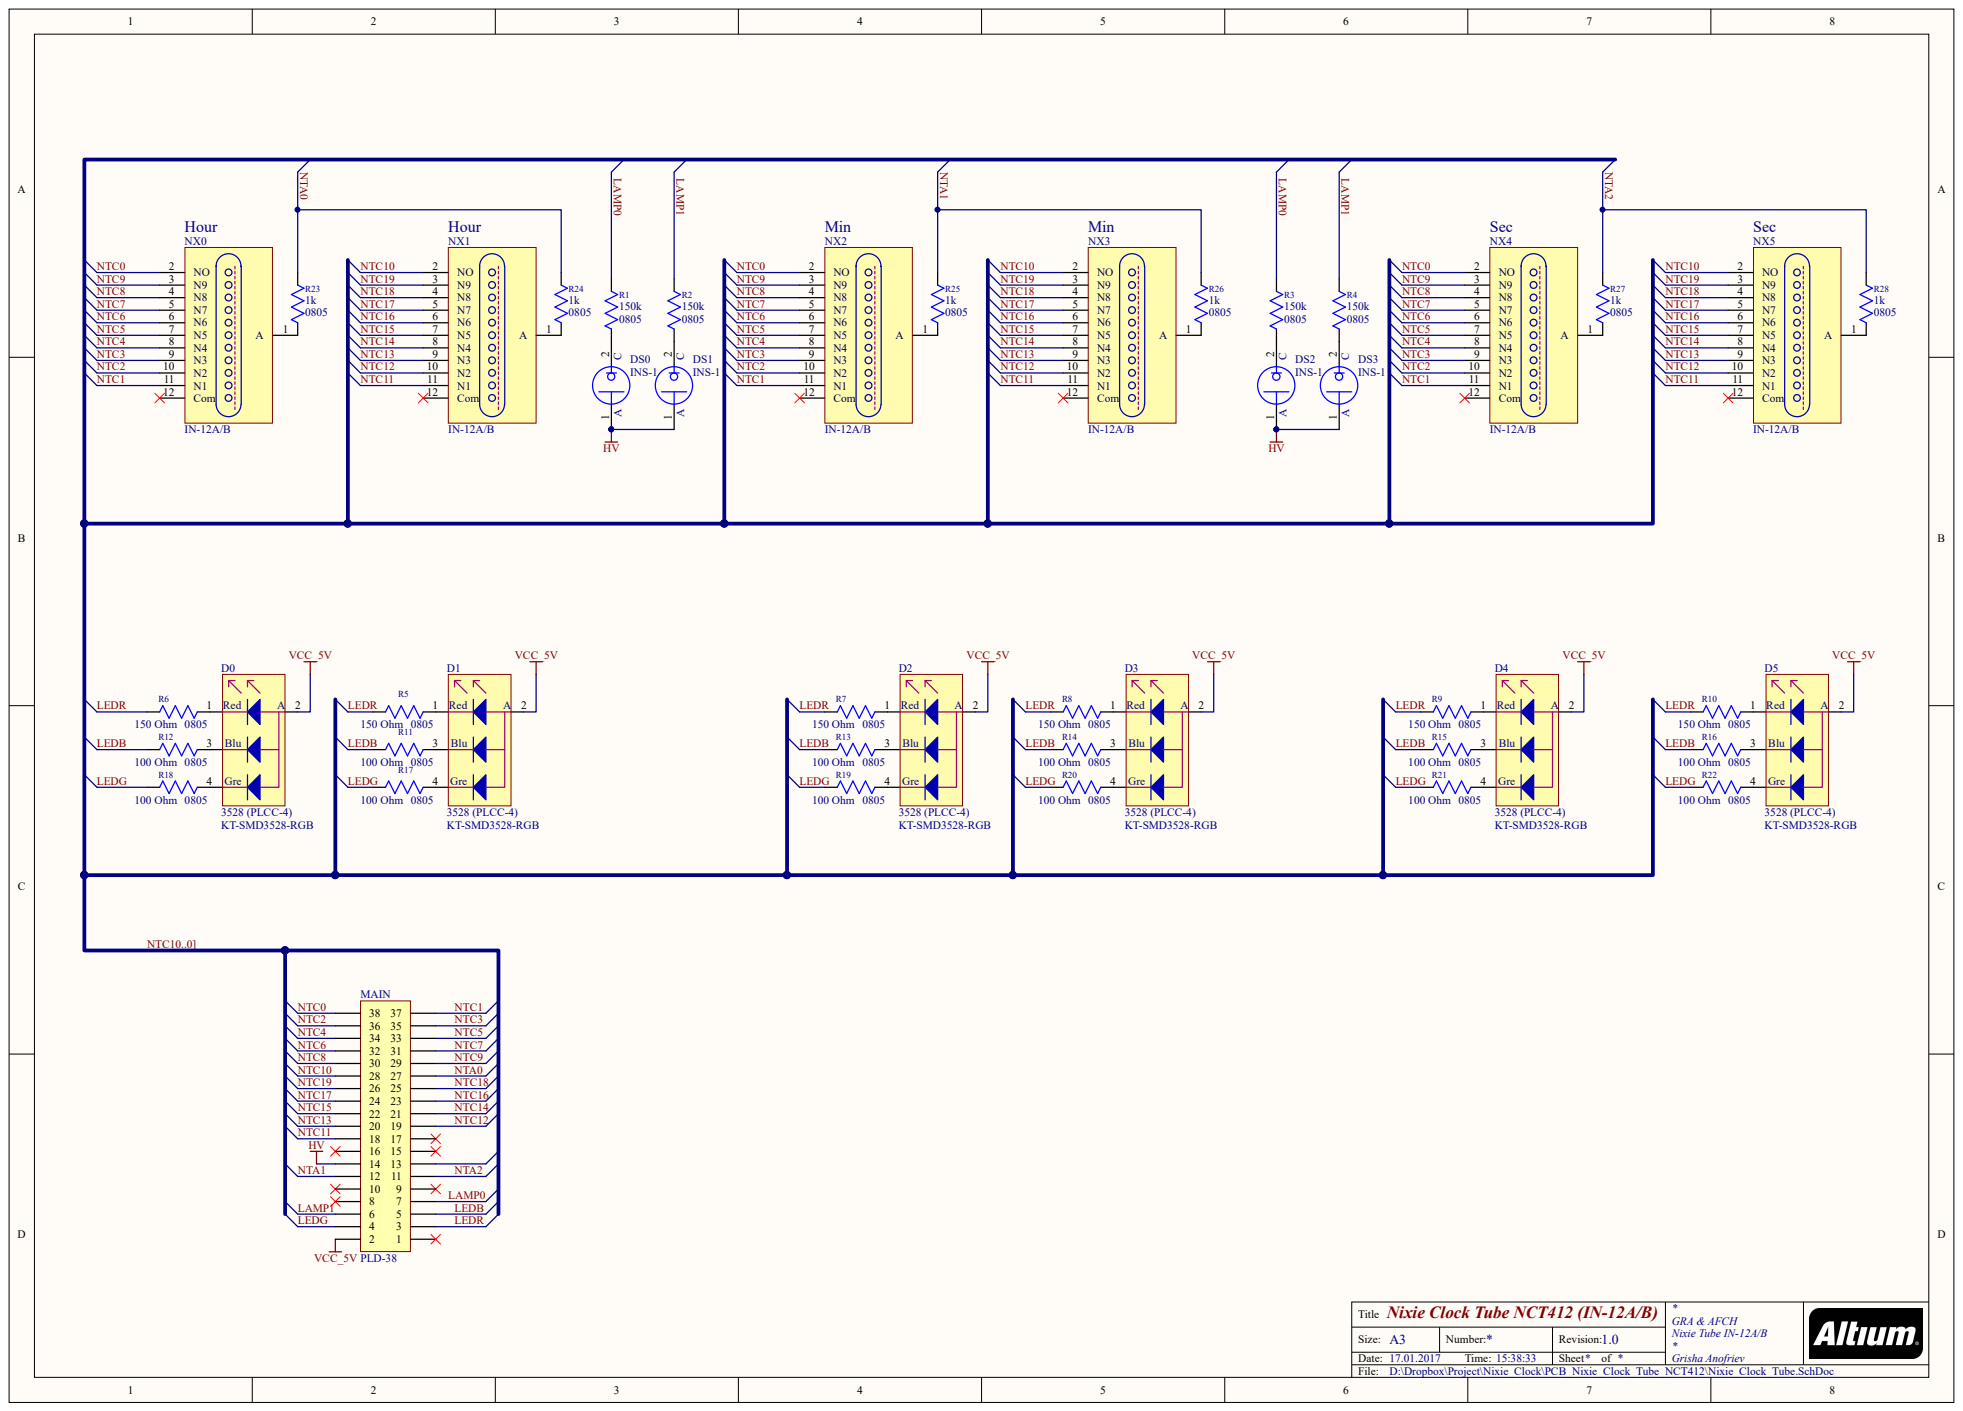
[picture p18: page 1]

Nixie Clock Tube NCT412 (IN-12A/B)
Title
