afch/NixieClock/Schemes/Scheme Tubes Board - NCT318 v1.1.pdf

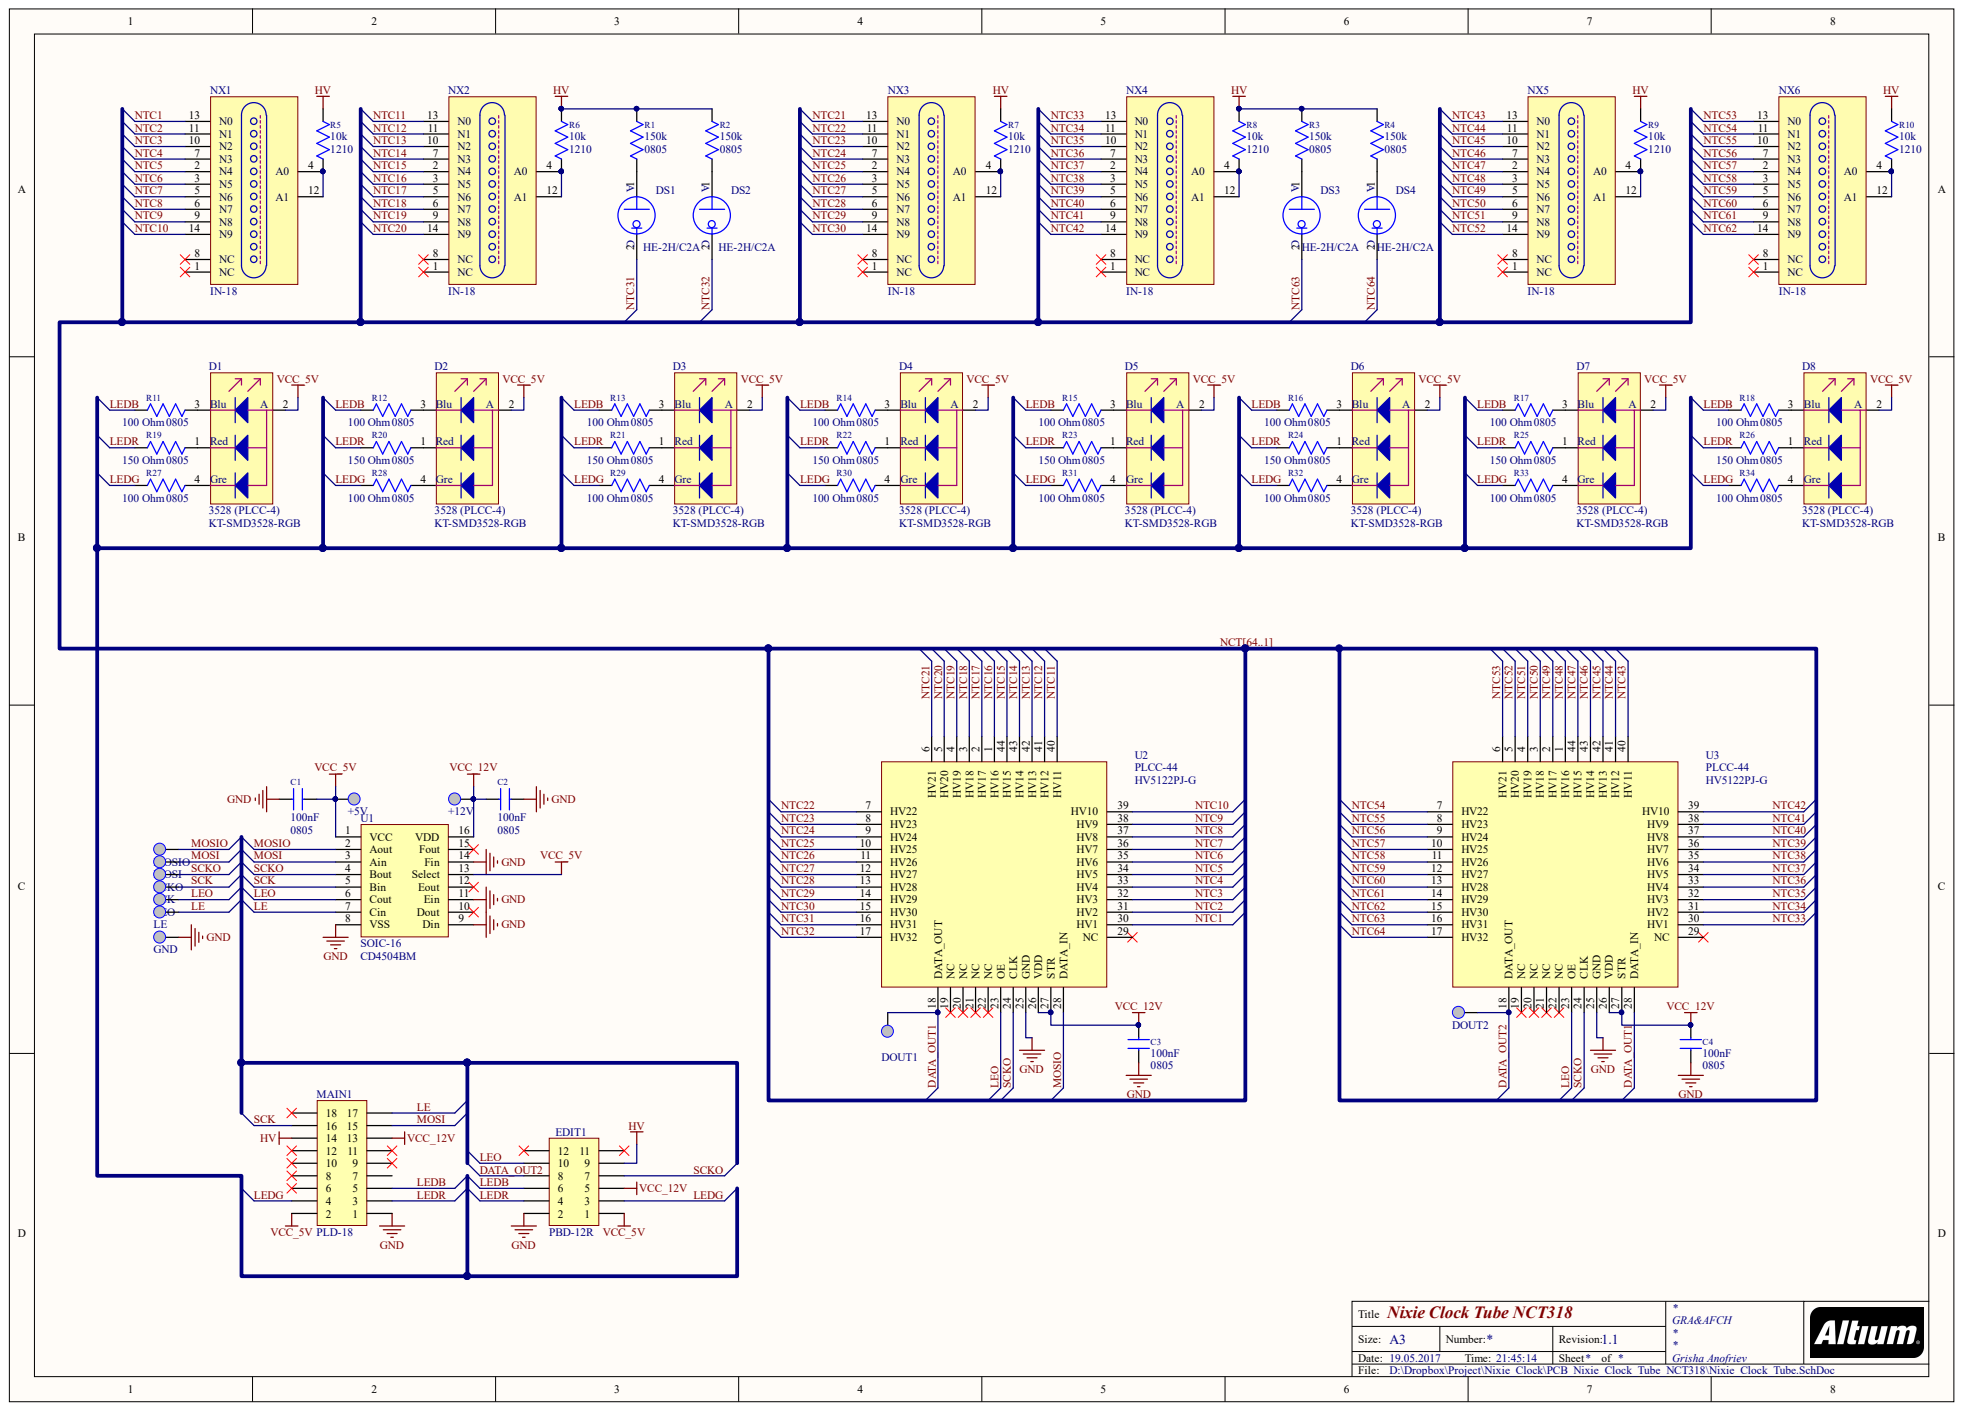
[picture p19: page 1]
