afch/NixieClock/Schemes/Scheme Tubes Board - NCT3566 v1.0.pdf

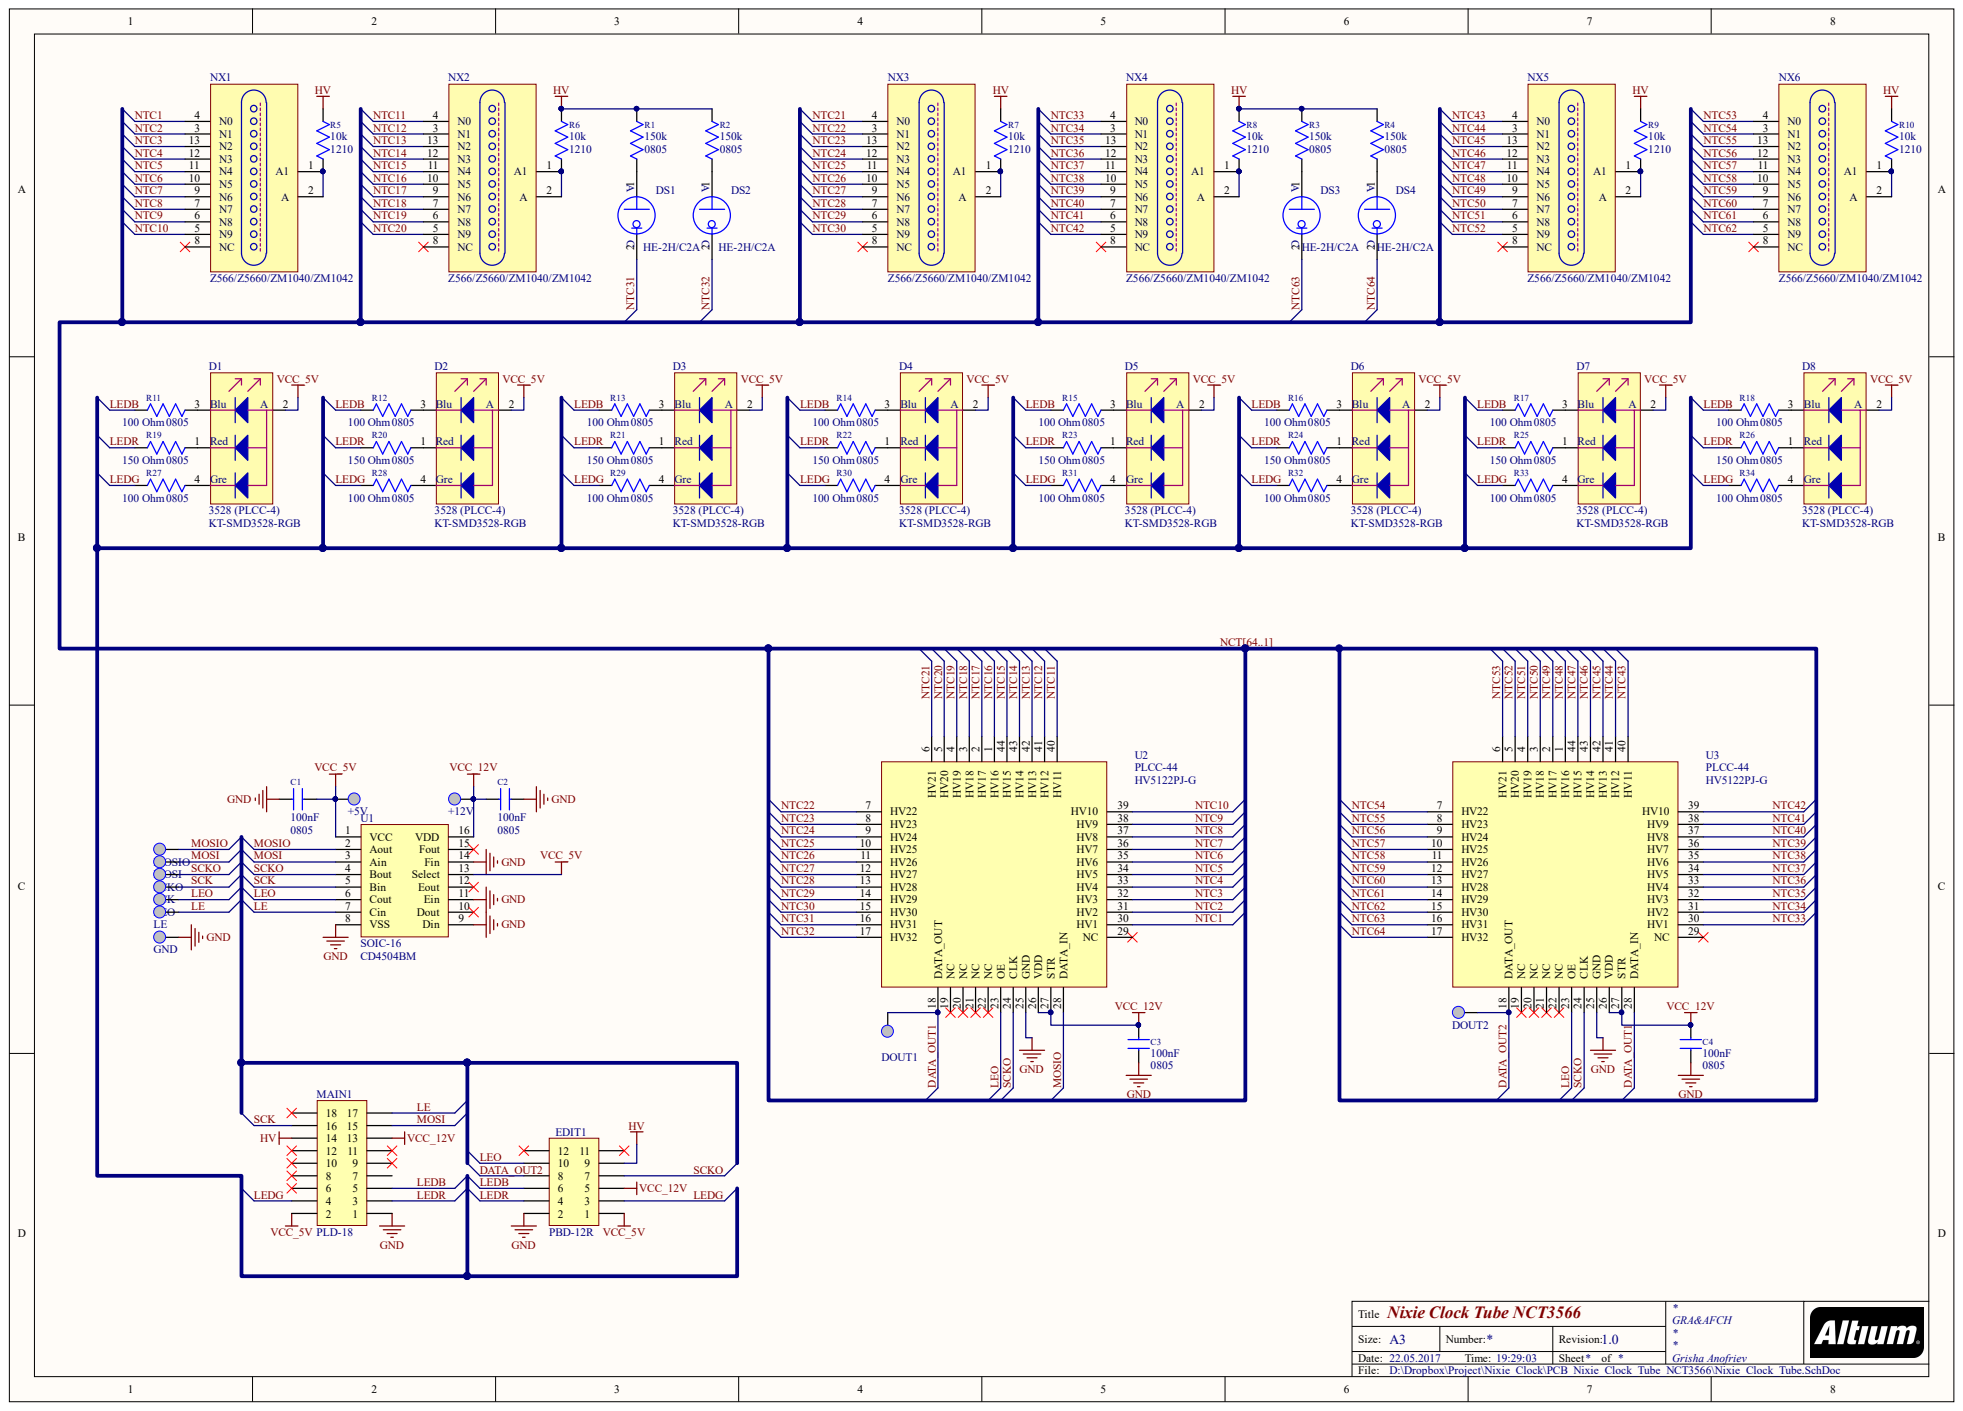
[picture p20: page 1]
