afch/NixieClock/Schemes/Scheme Tubes Board - NCT414 v1.1.pdf

## Hour

## Hour

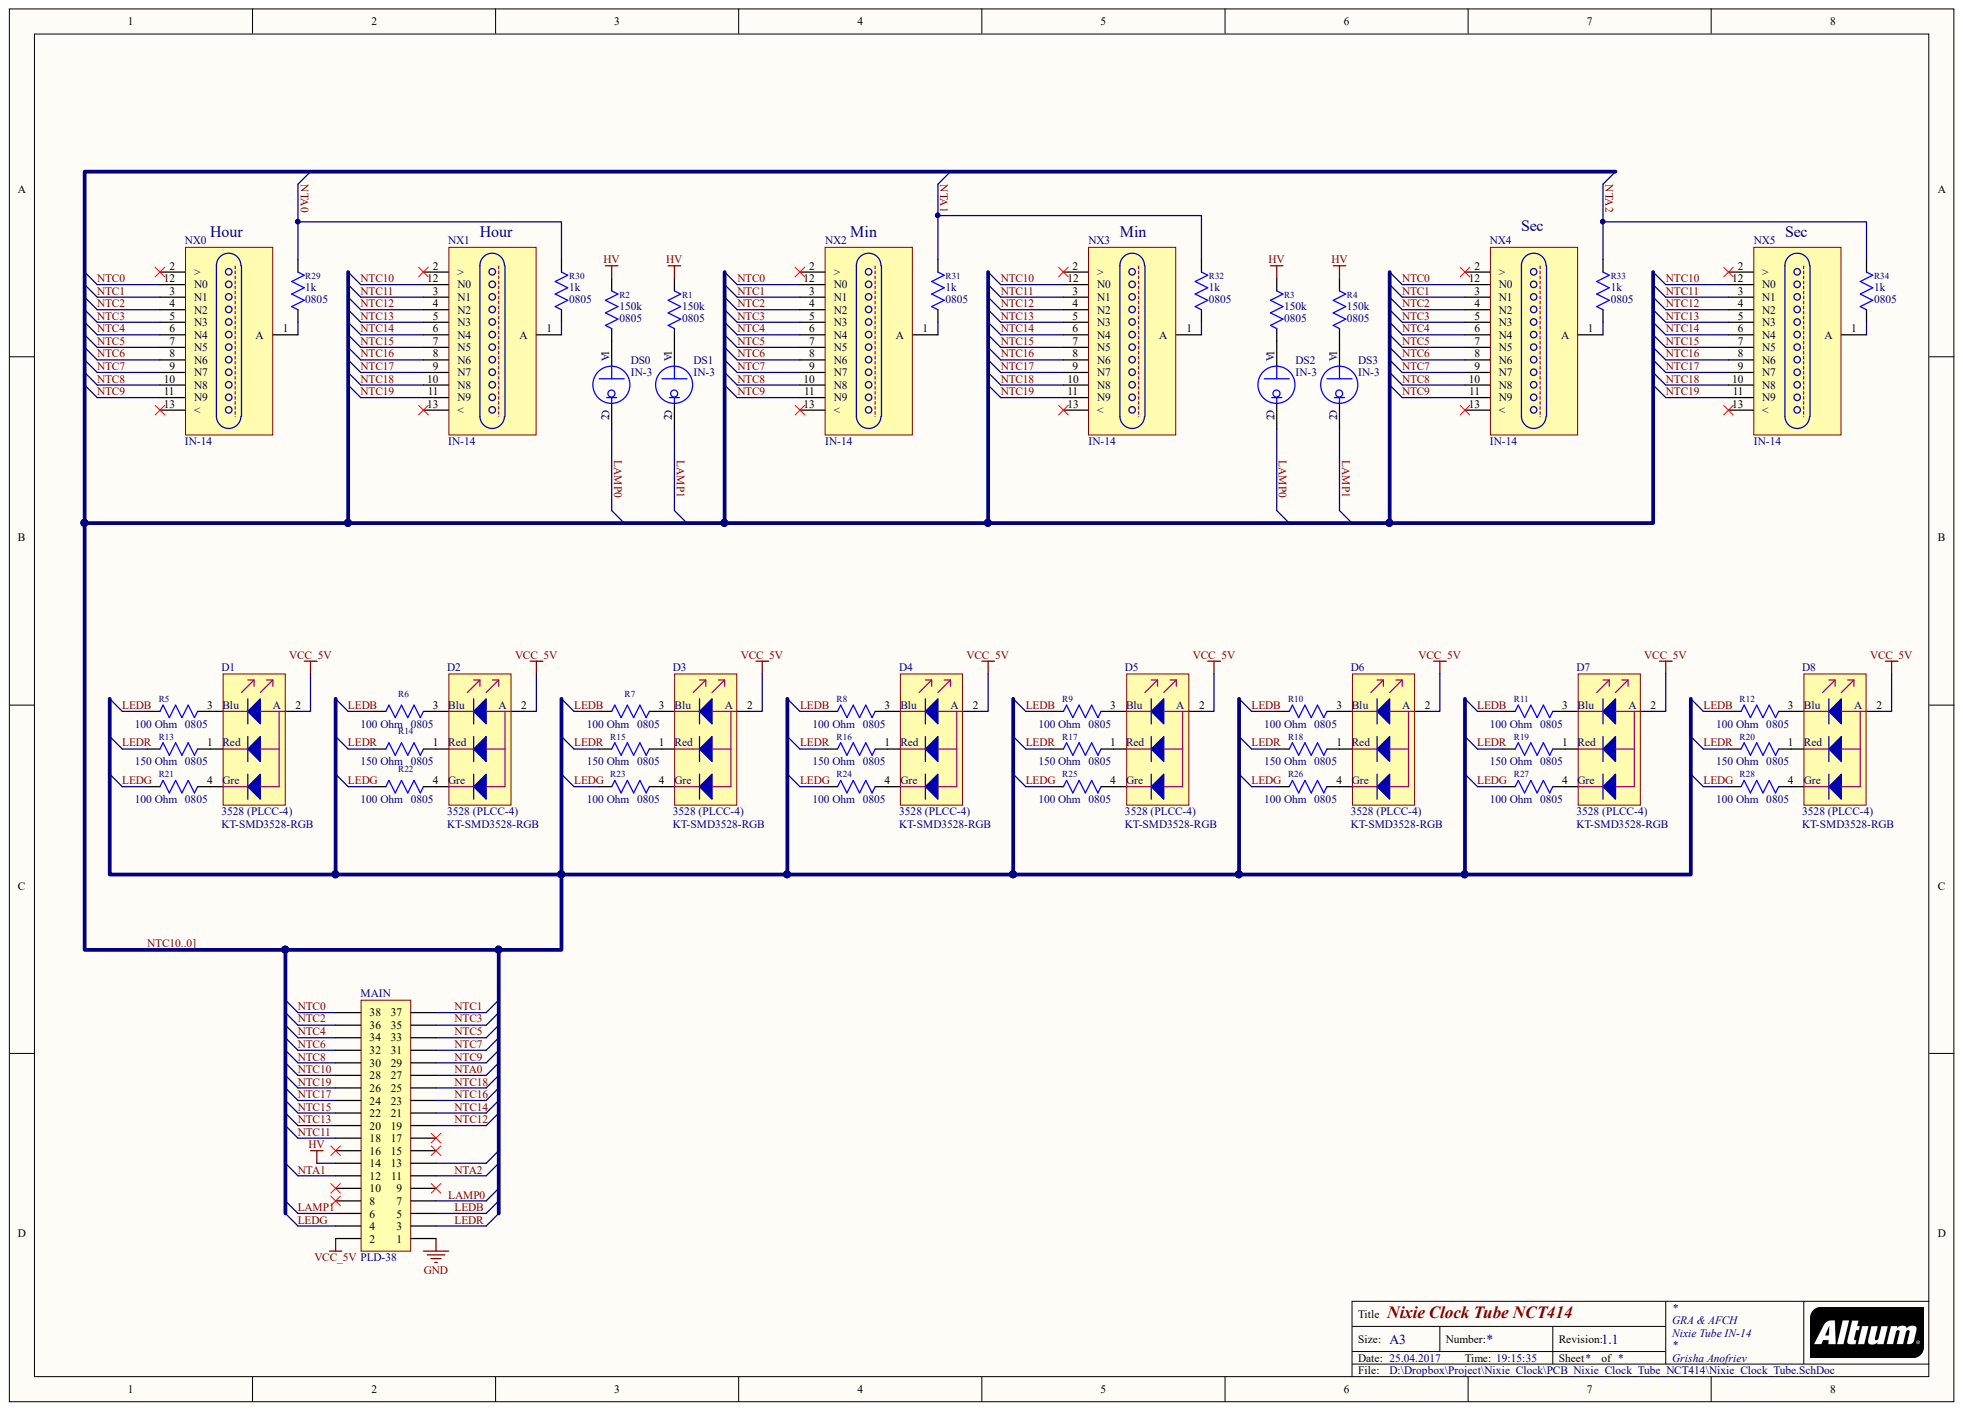
[picture p21: page 1]
