afch/NixieClock/Schemes/Scheme Tubes Board - NCT4573 v1.0.pdf

## Hour

Hour | 1

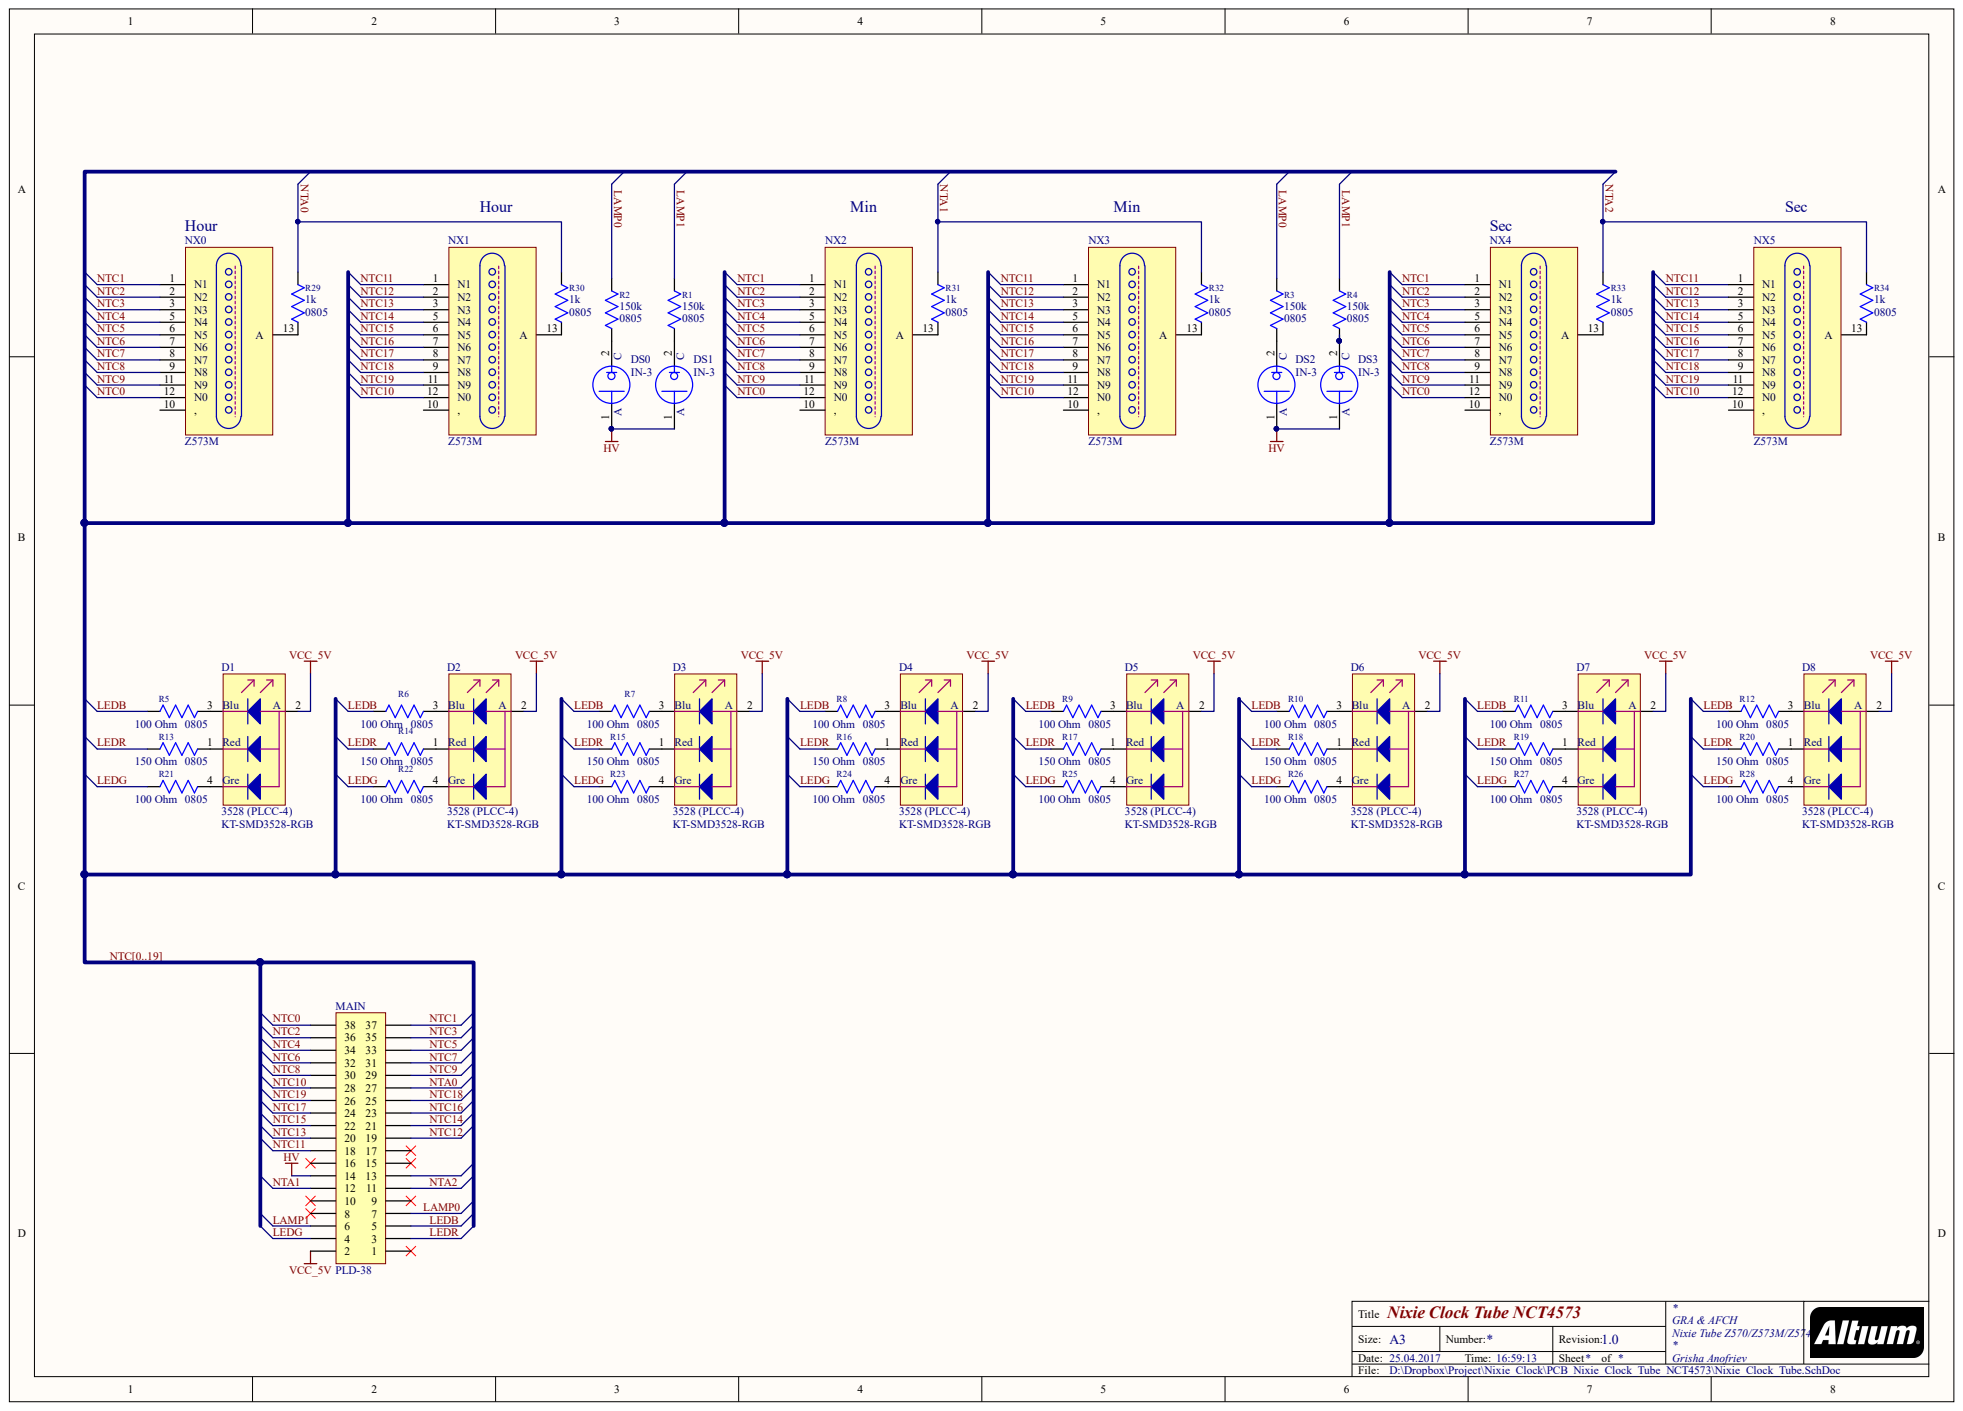
[picture p22: page 1]
