afch/NixieClock/Schemes/Scheme Tubes Board - NCT818 v1.0.pdf

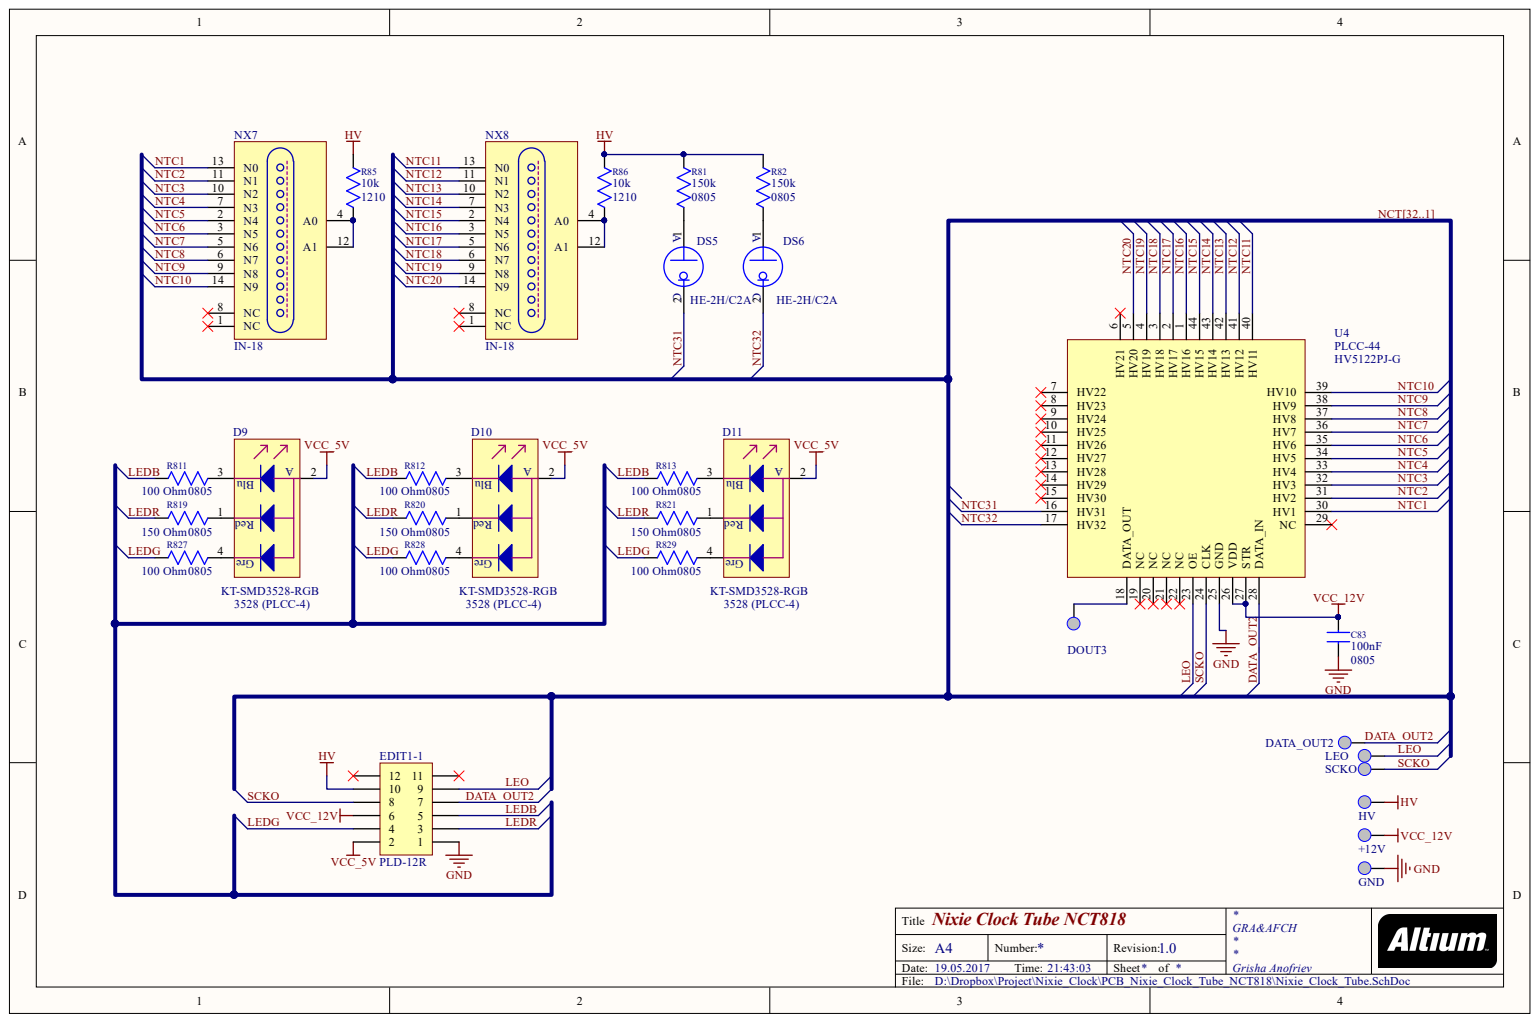
[picture p23: page 1]
