afch/NixieClock/Schemes/Previous Versions/Scheme Nixie Clock Main Board MCU - NCM106 v1.1.pdf

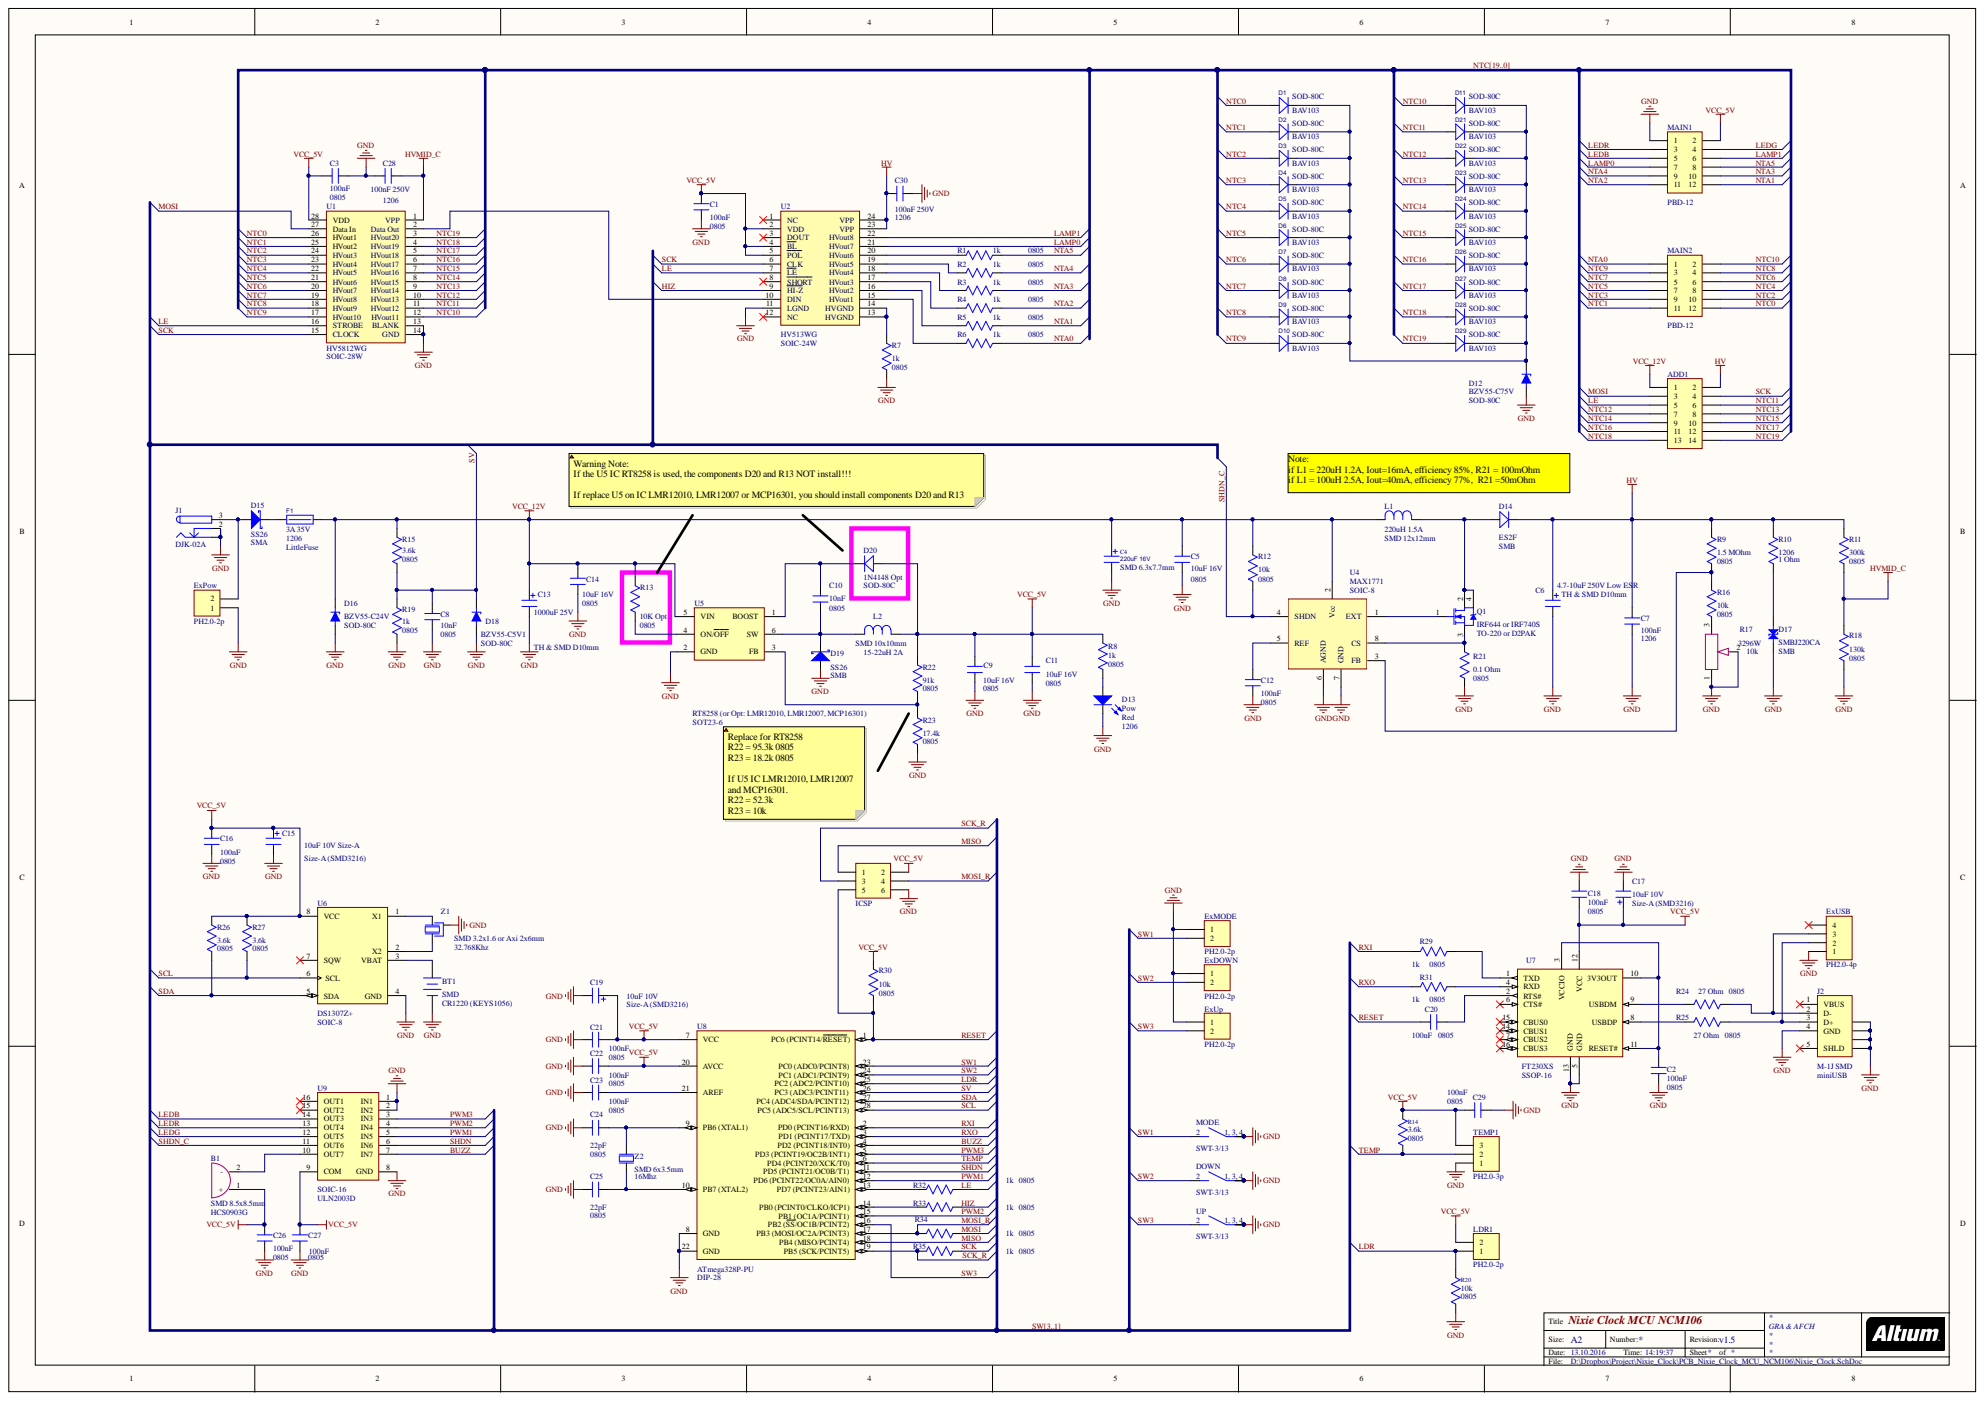
[picture p24: page 1]

Warning Note:
If the U5 IC RT8258 is used, the components D20 and R13 NOT install!!!

If replace U5 on IC LMR12010, LMR12007 or MCP16301, you should install components D20 and R13

SCK_R

Nixie Clock MCU NCM106 Title | * GRA & AFCH * * *

Size: A2 | Number: * | Revision: v1.5

Date: 13.10.2016 Time: 14:19:37 | | Sheet * of *

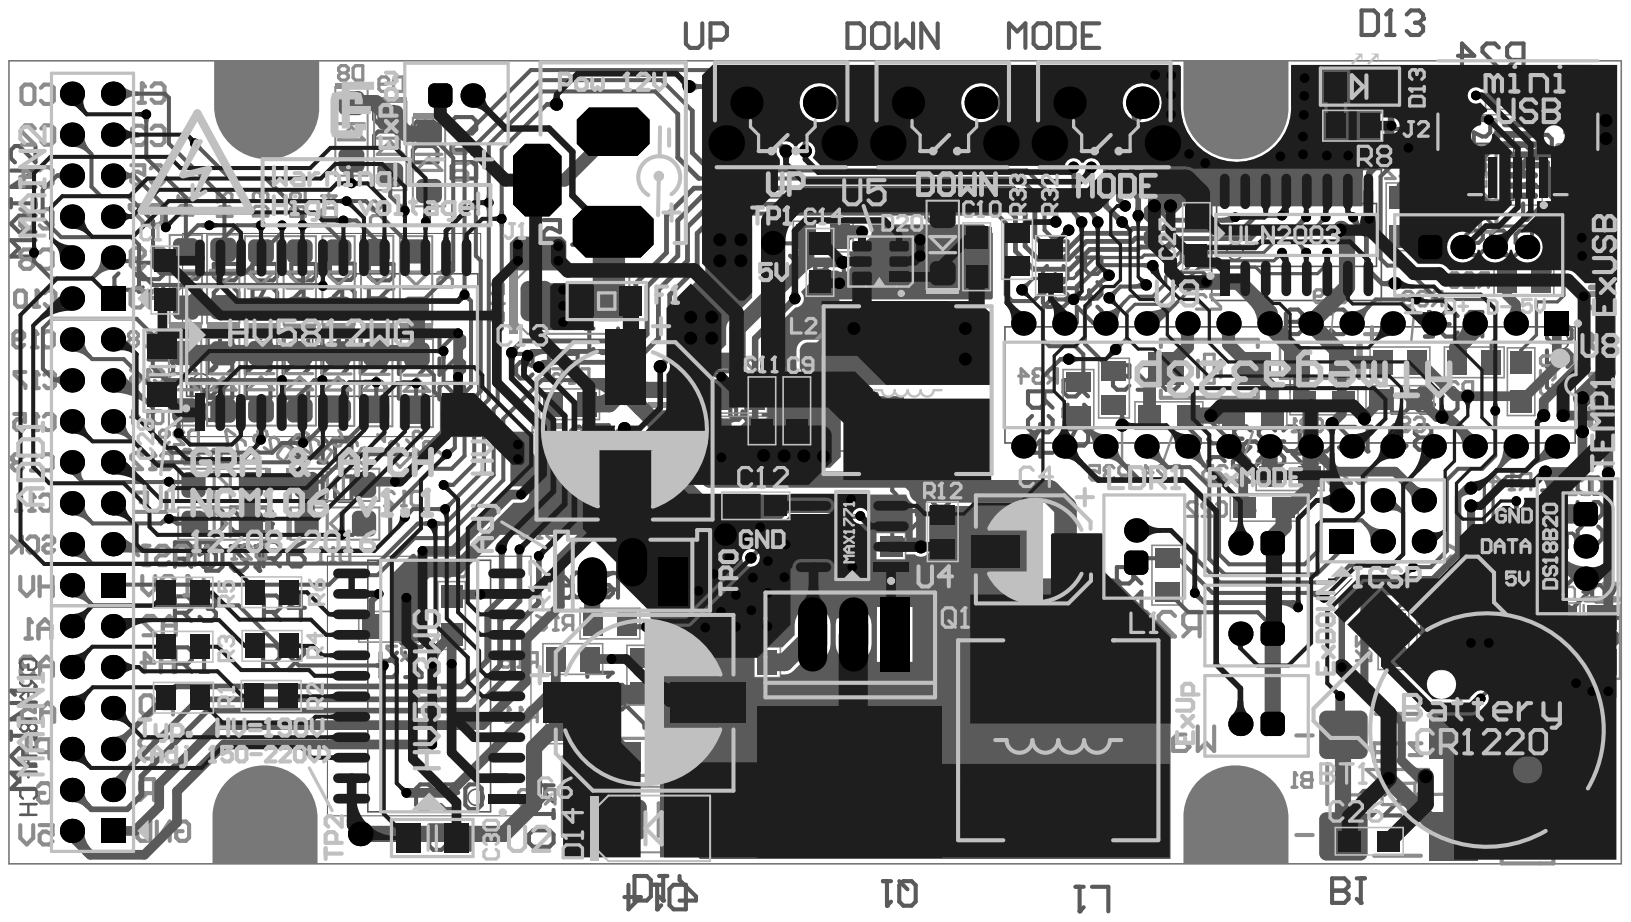
[picture p25: page 2]

# Board S
