afch/NixieClock/Schemes/Previous Versions/Scheme Tubes Board - NCT212 v1.2.pdf

## Hour

## Hour

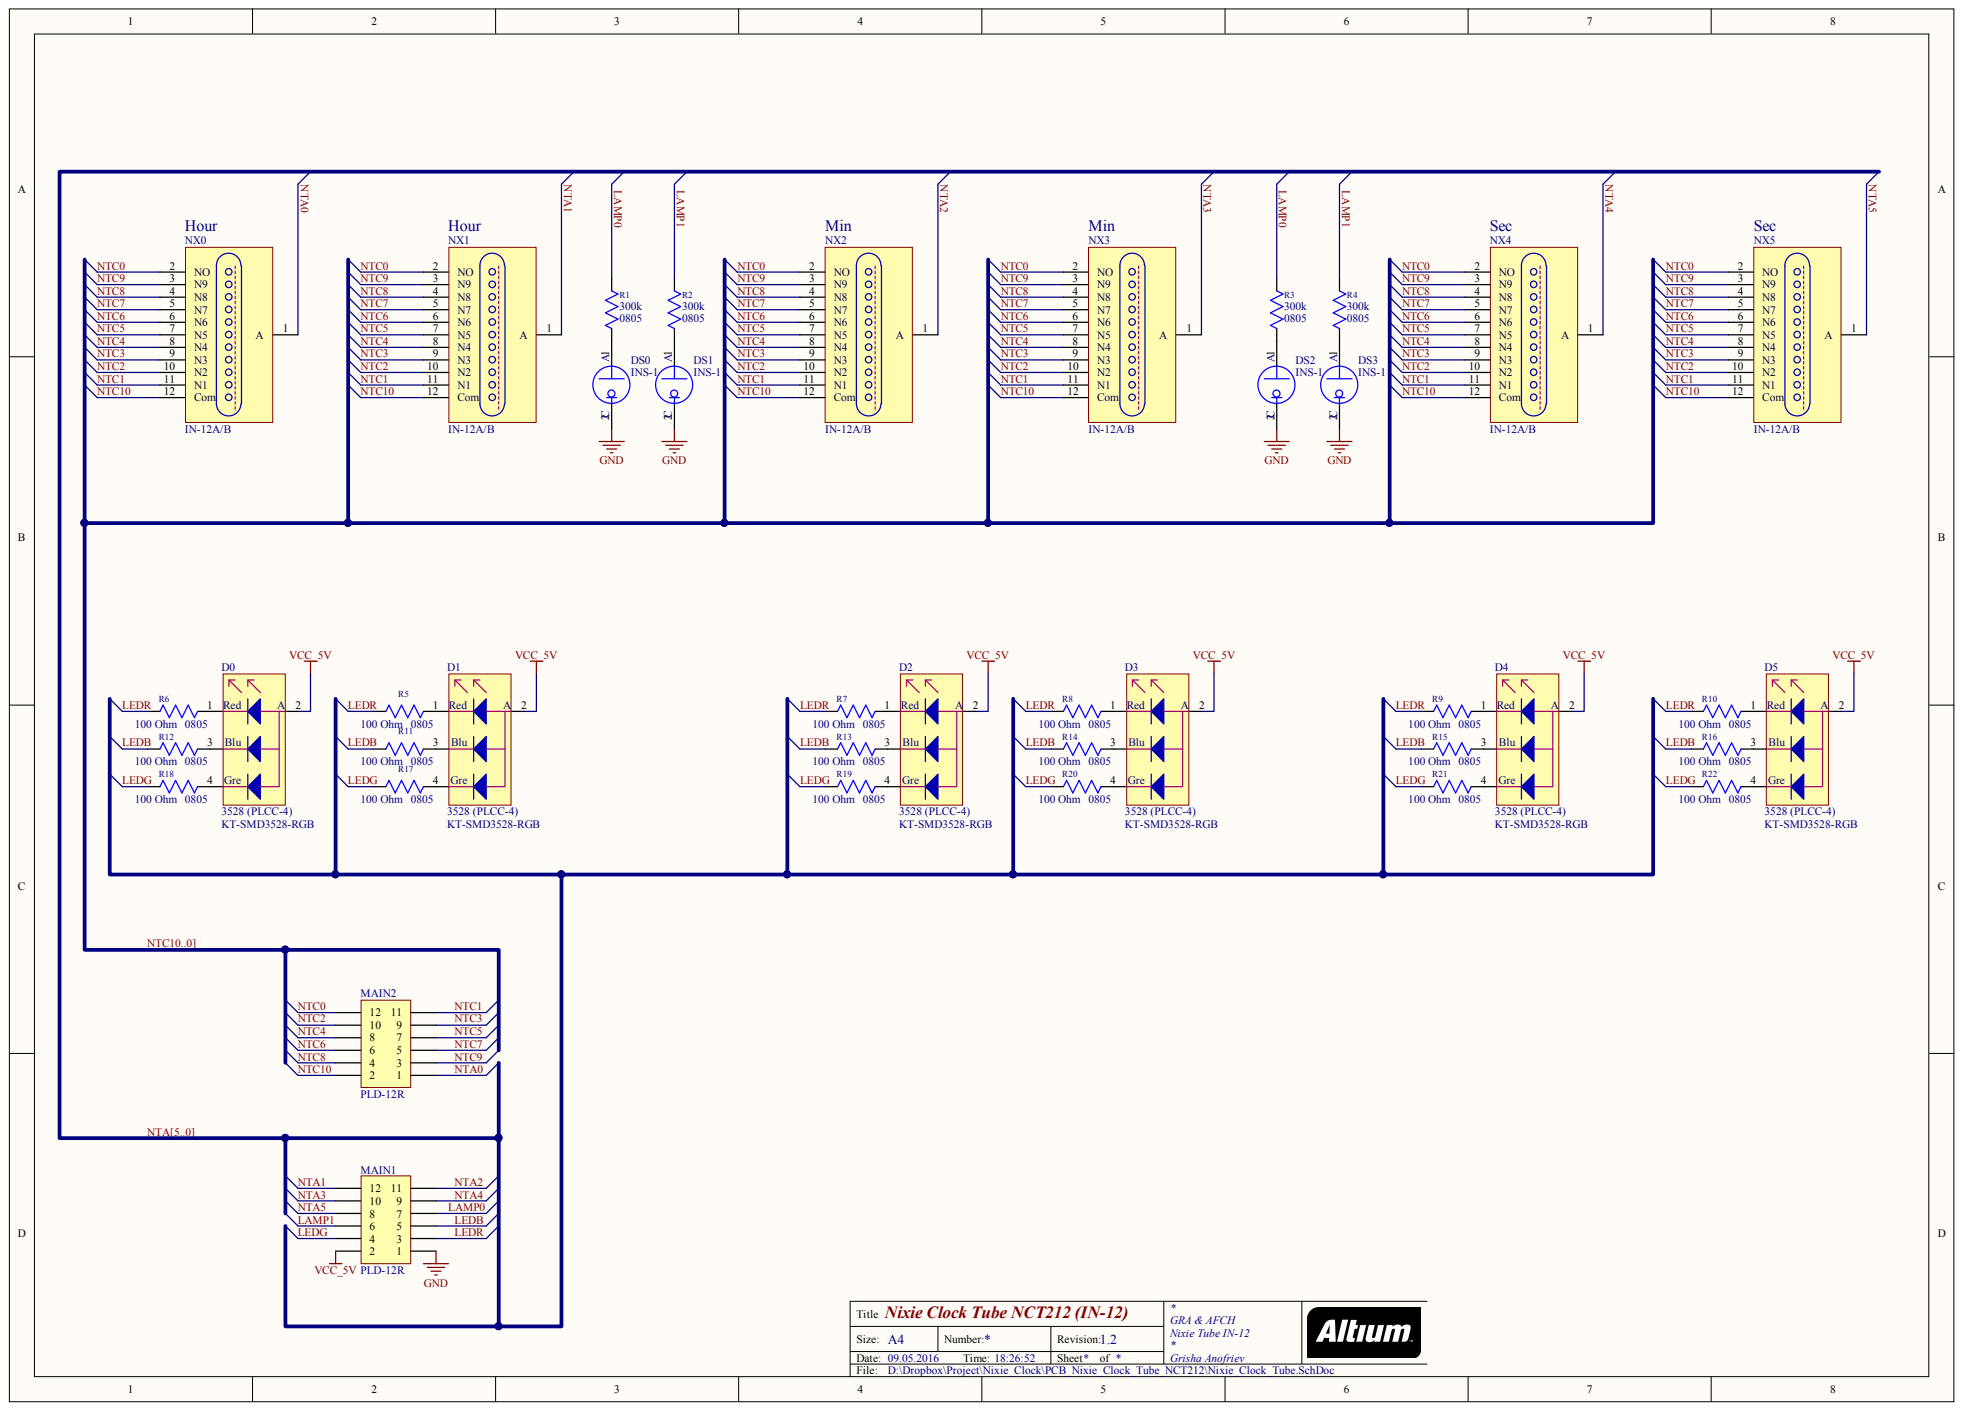
[picture p26: page 1]

Nixie Clock Tube NCT212 (IN-12)
Title
