afch/NixieClock/Schemes/Previous Versions/Scheme Tubes Board - NCT214 v1.2.pdf

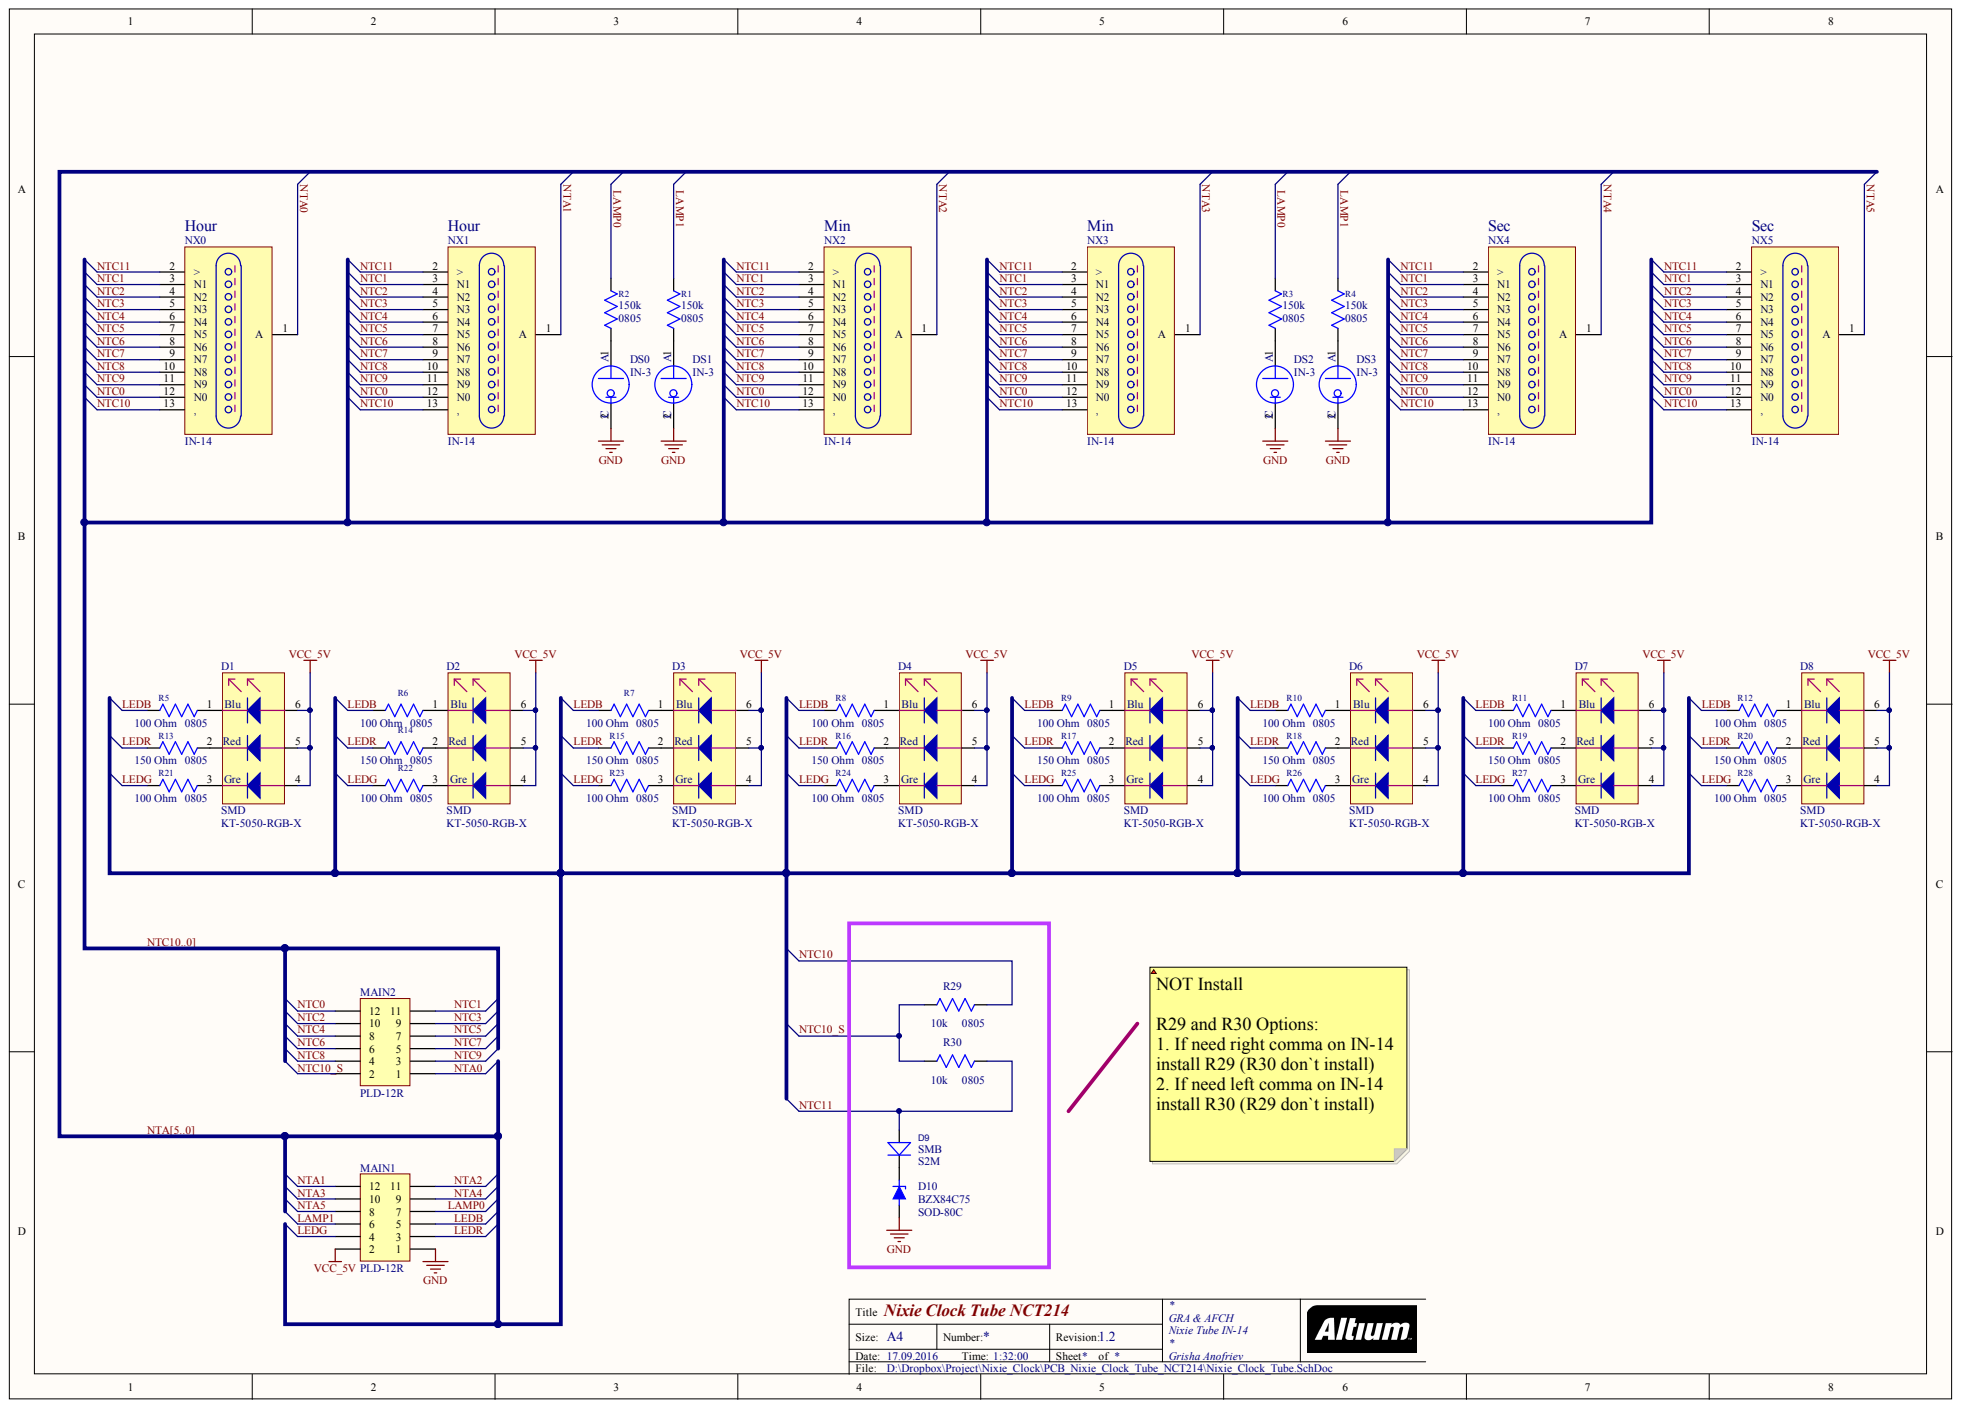
[picture p27: page 1]

R29 and R30 Options:
1. If need right comma on IN-14
install R29 (R30 don`t install)
2. If need left comma on IN-14
install R30 (R29 don`t install)

Nixie Clock Tube NCT214 Title | * GRA & AFCH Nixie Tube IN-14 * Grisha Anofriev

Size: A4 | Number: * | Revision: 1.2
Date: 17.09.2016 Time: 1:32:00 | | Sheet * of *
