afch/NixieClock/Schemes/Previous Versions/Scheme Tubes Board - NCT408 v1.0.pdf

## Hour

Hour | 1

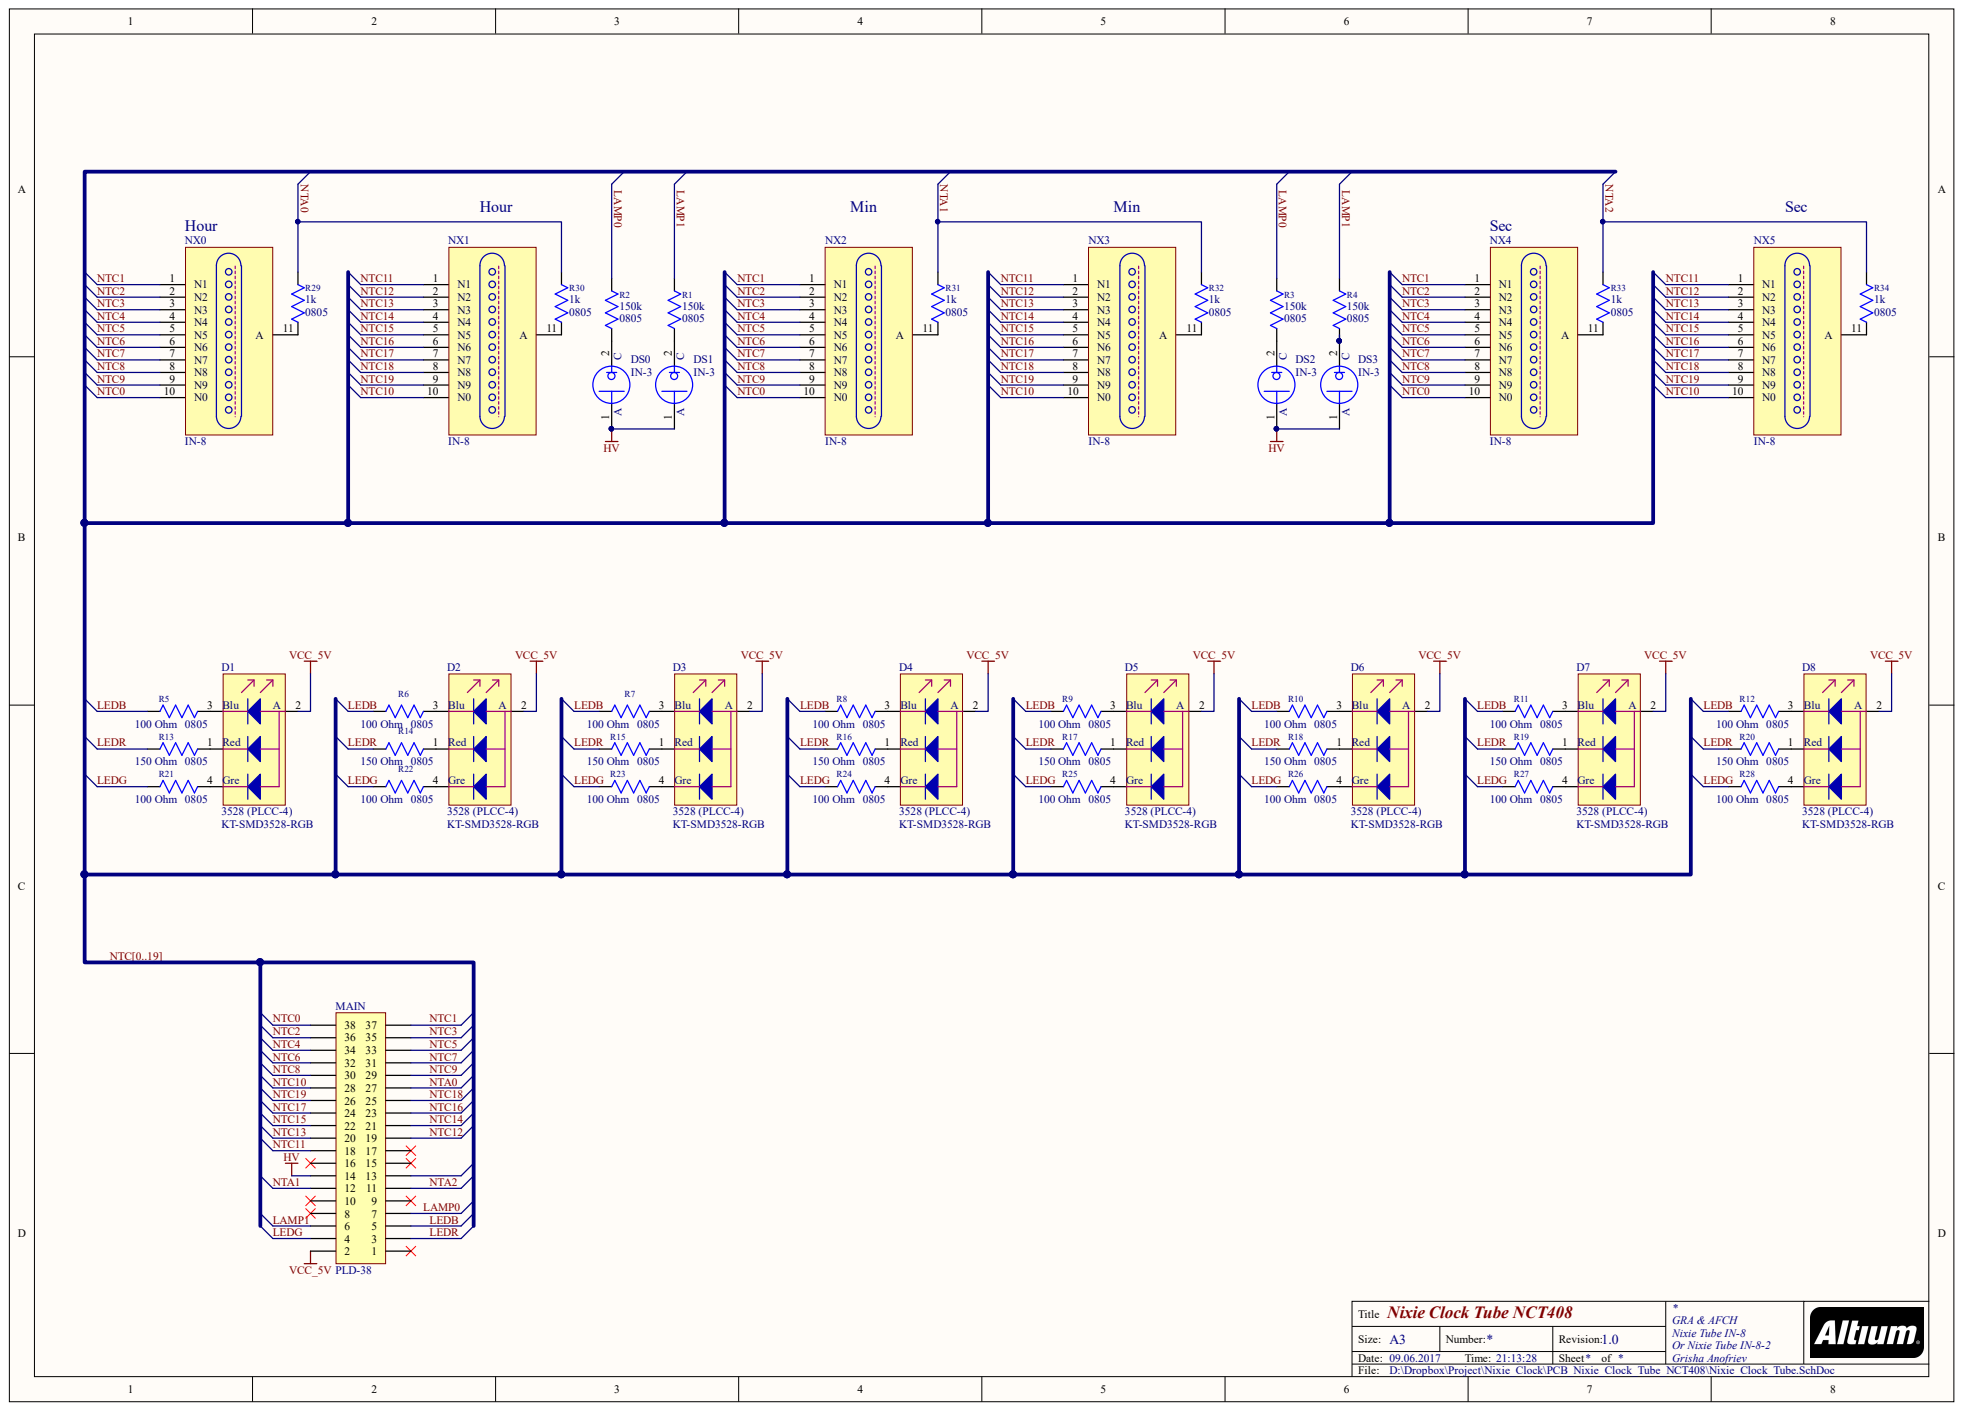
[picture p28: page 1]

GRA & AFCH
Nixie Tube IN-8
Or Nixie Tube IN-8-2
