afch/NixieClock/Schemes/Previous Versions/Scheme Tubes Board - NCT208 v1.2.pdf

## Hour

## Hour

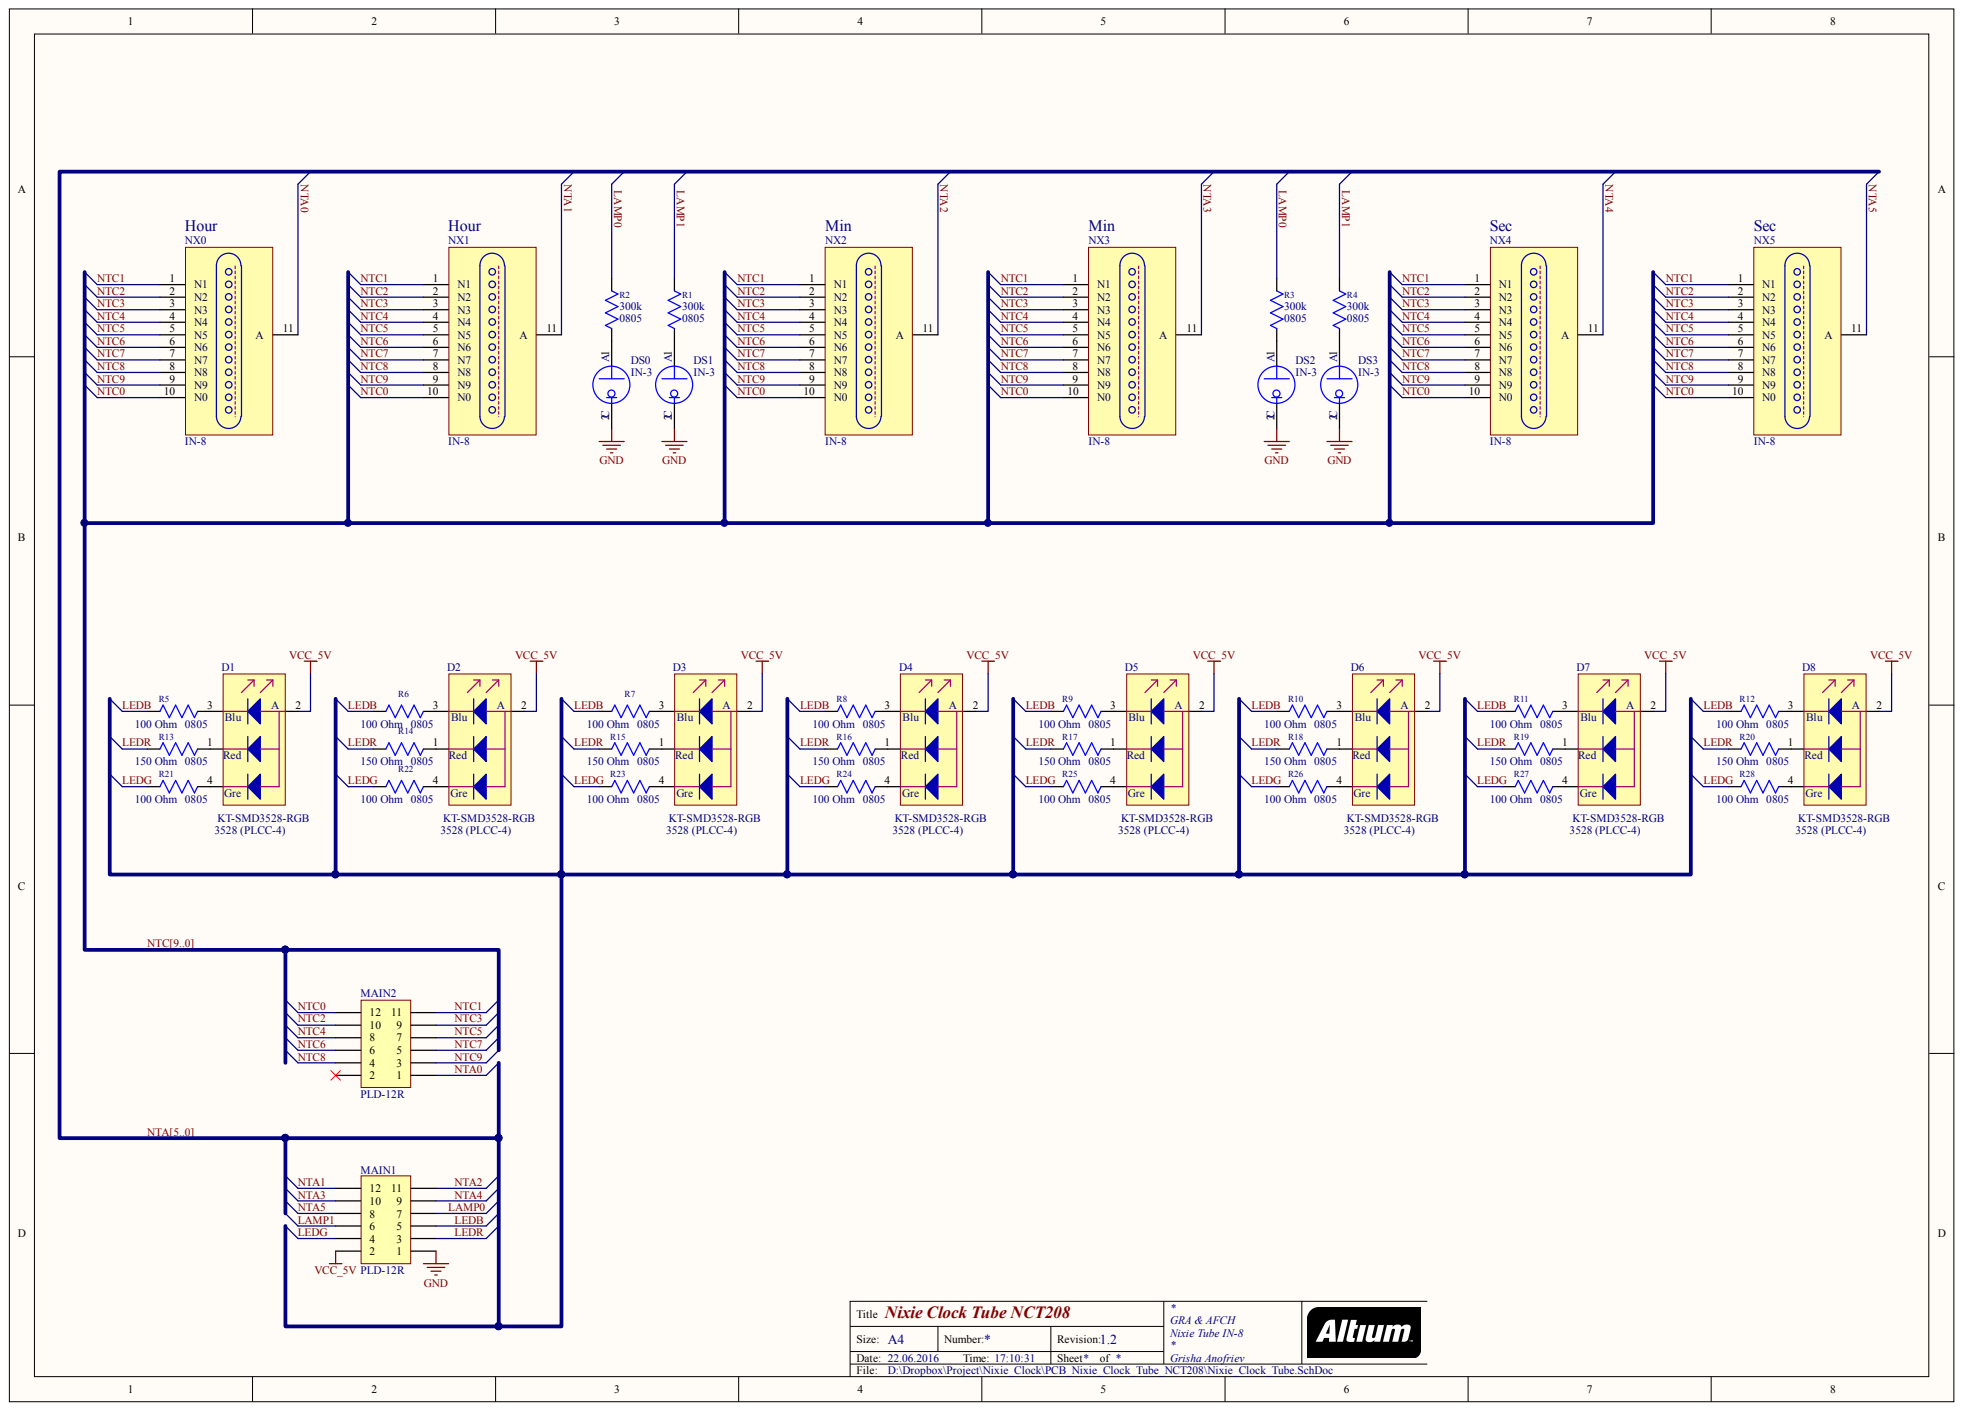
[picture p29: page 1]
