afch/NixieClock/Schemes/Previous Versions/Scheme Tubes Board - NCT216 v1.0.pdf

## Hour

## Hour

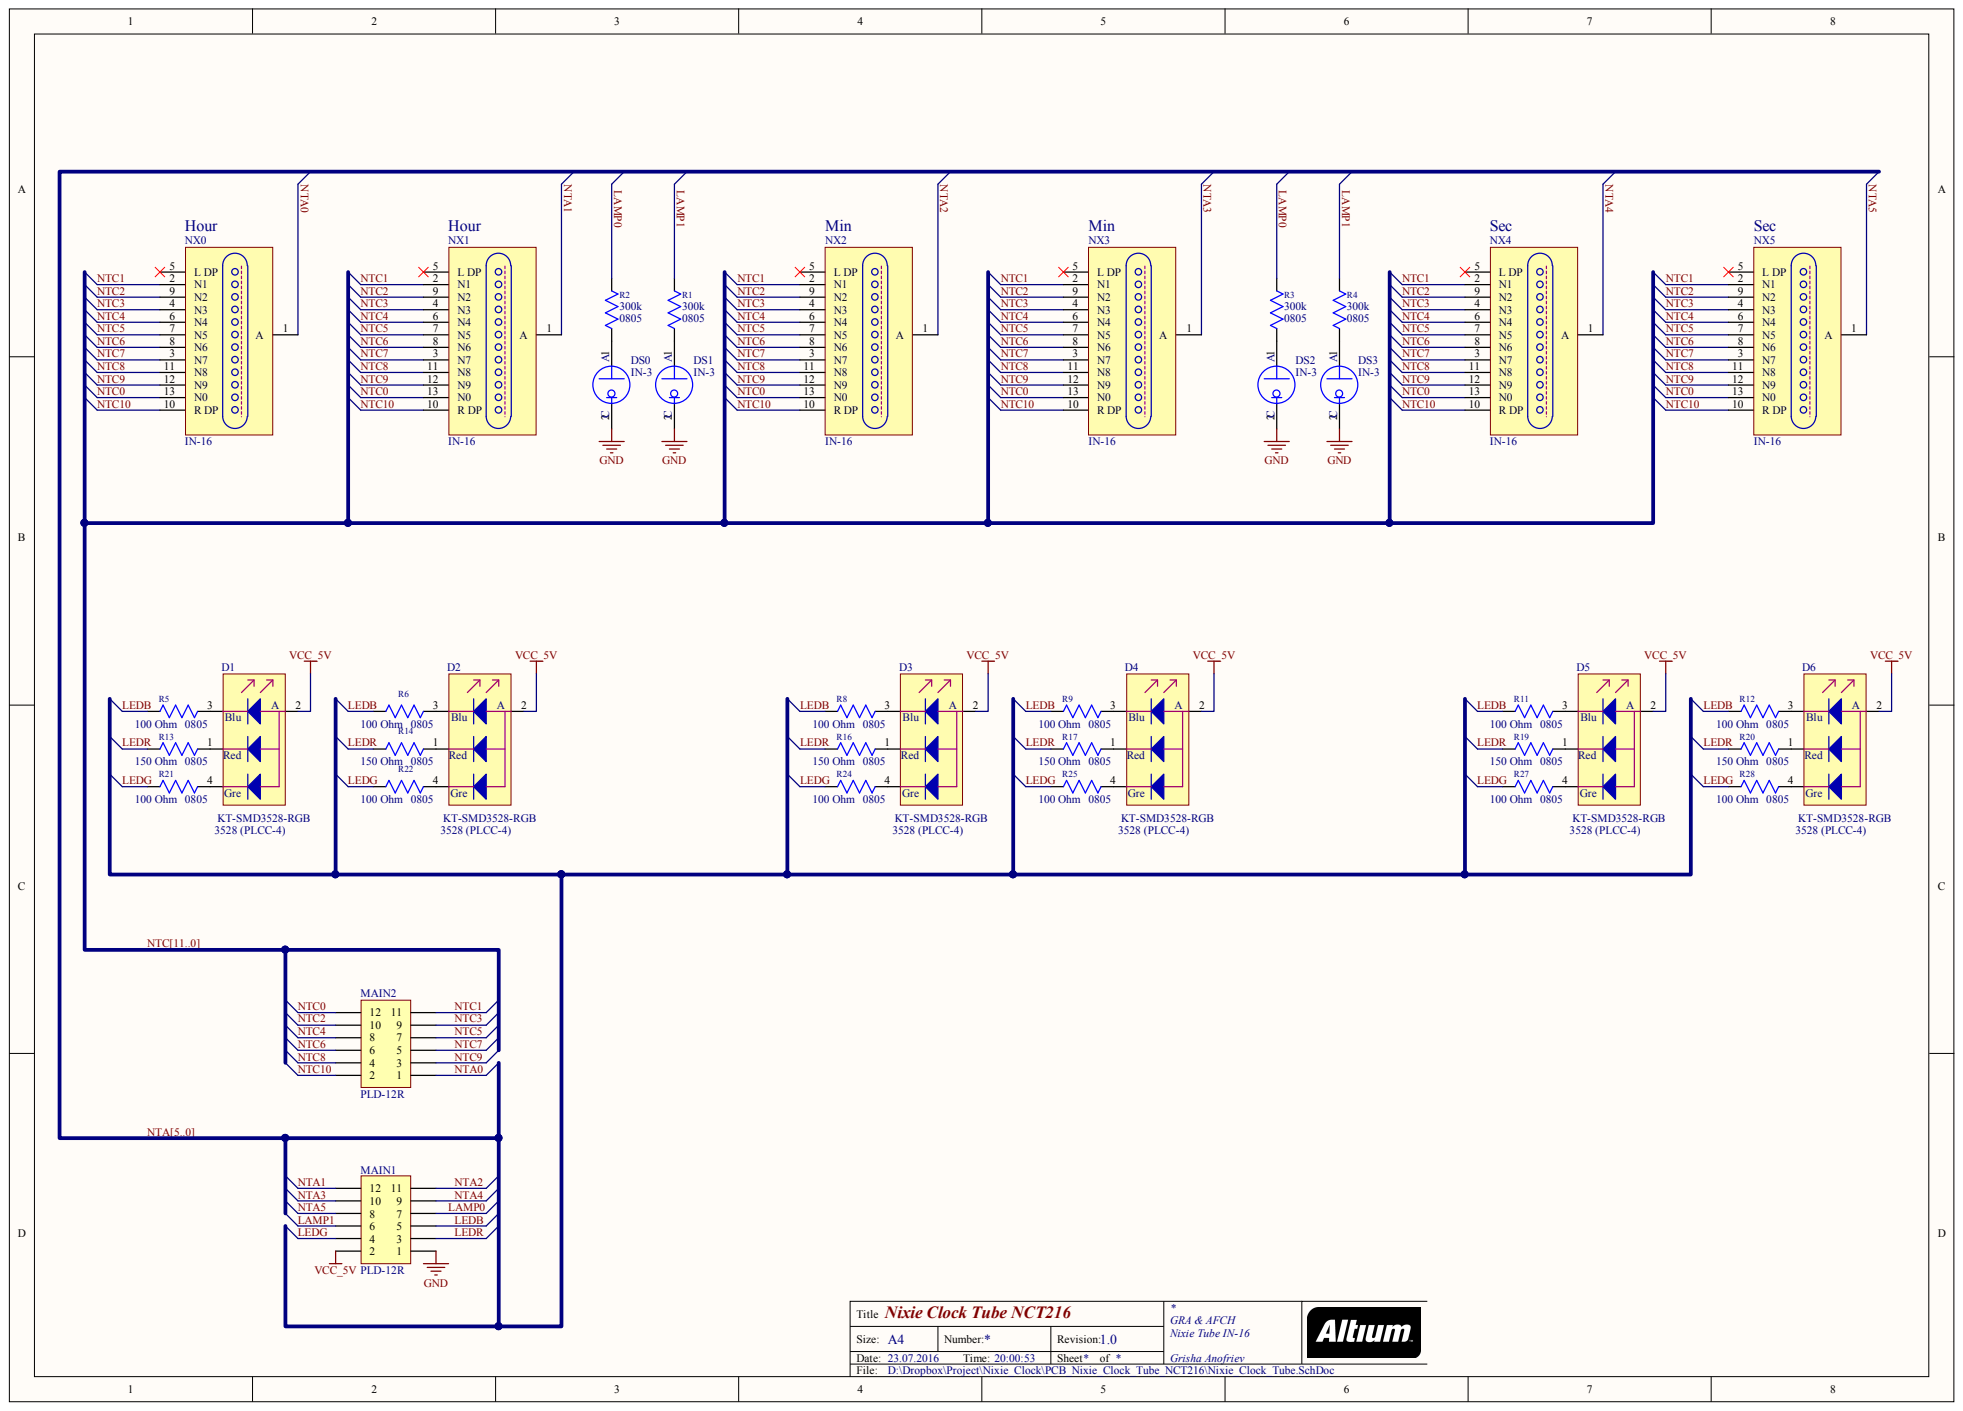
[picture p30: page 1]
