afch/NixieClock/Schemes/Previous Versions/Scheme Tubes Board - NCT218 v1.2.pdf

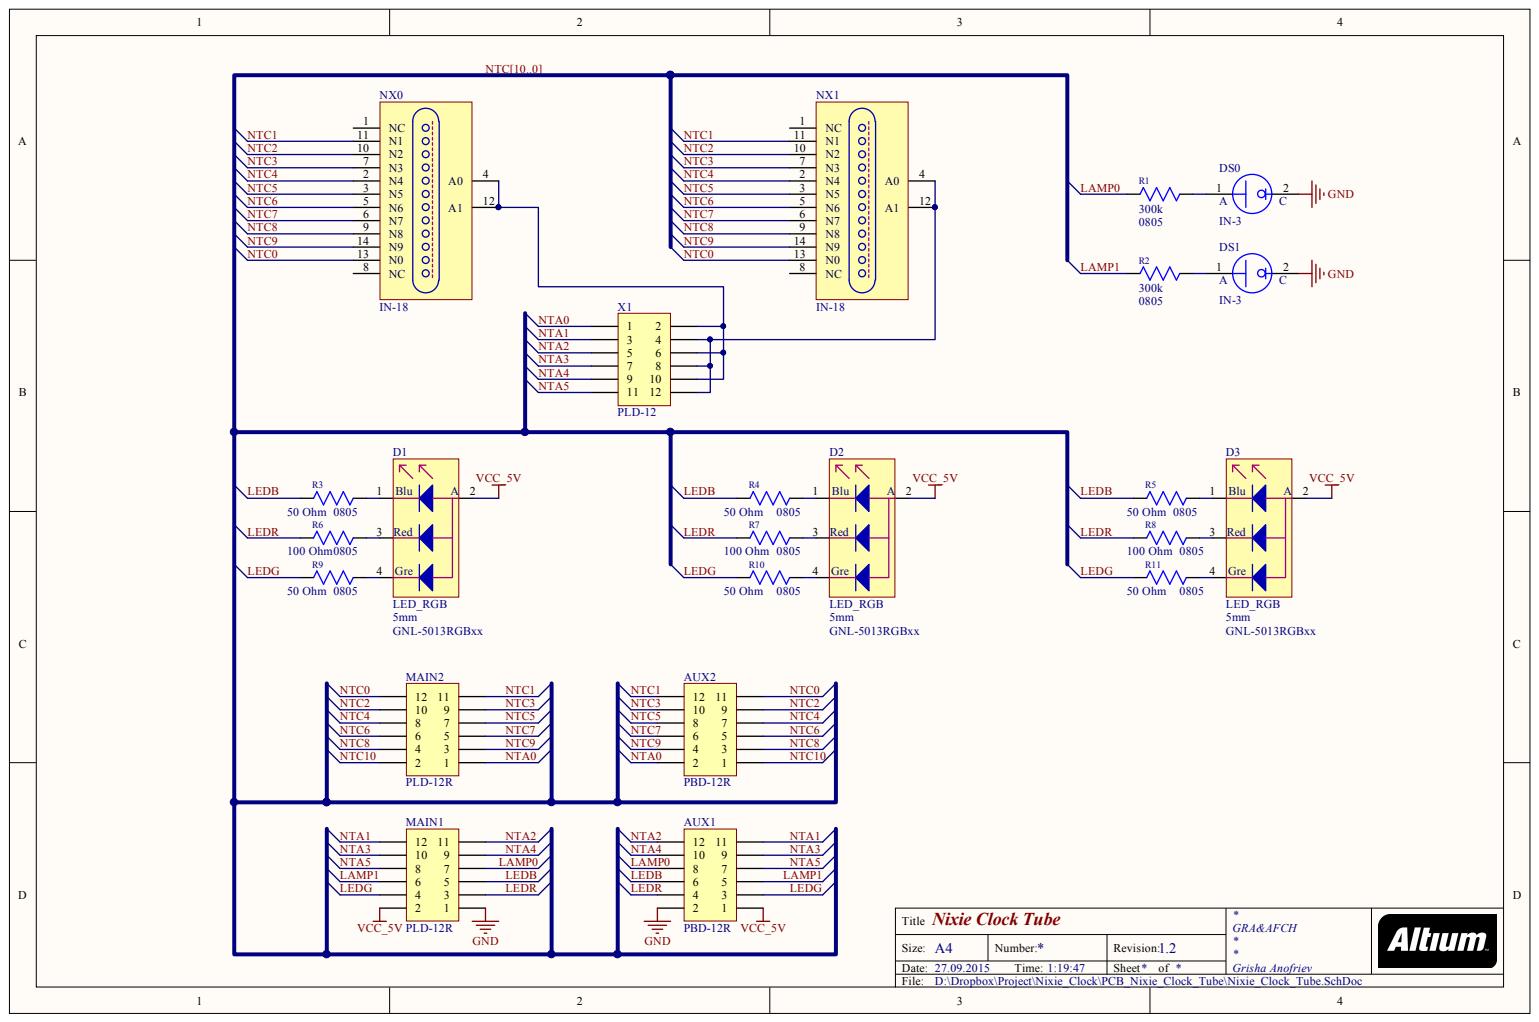
[picture p31: page 1]
