afch/NixieClock/Schemes/Previous Versions/Scheme Tubes Board - NCT282 v1.0.pdf

## Hour

## Hour

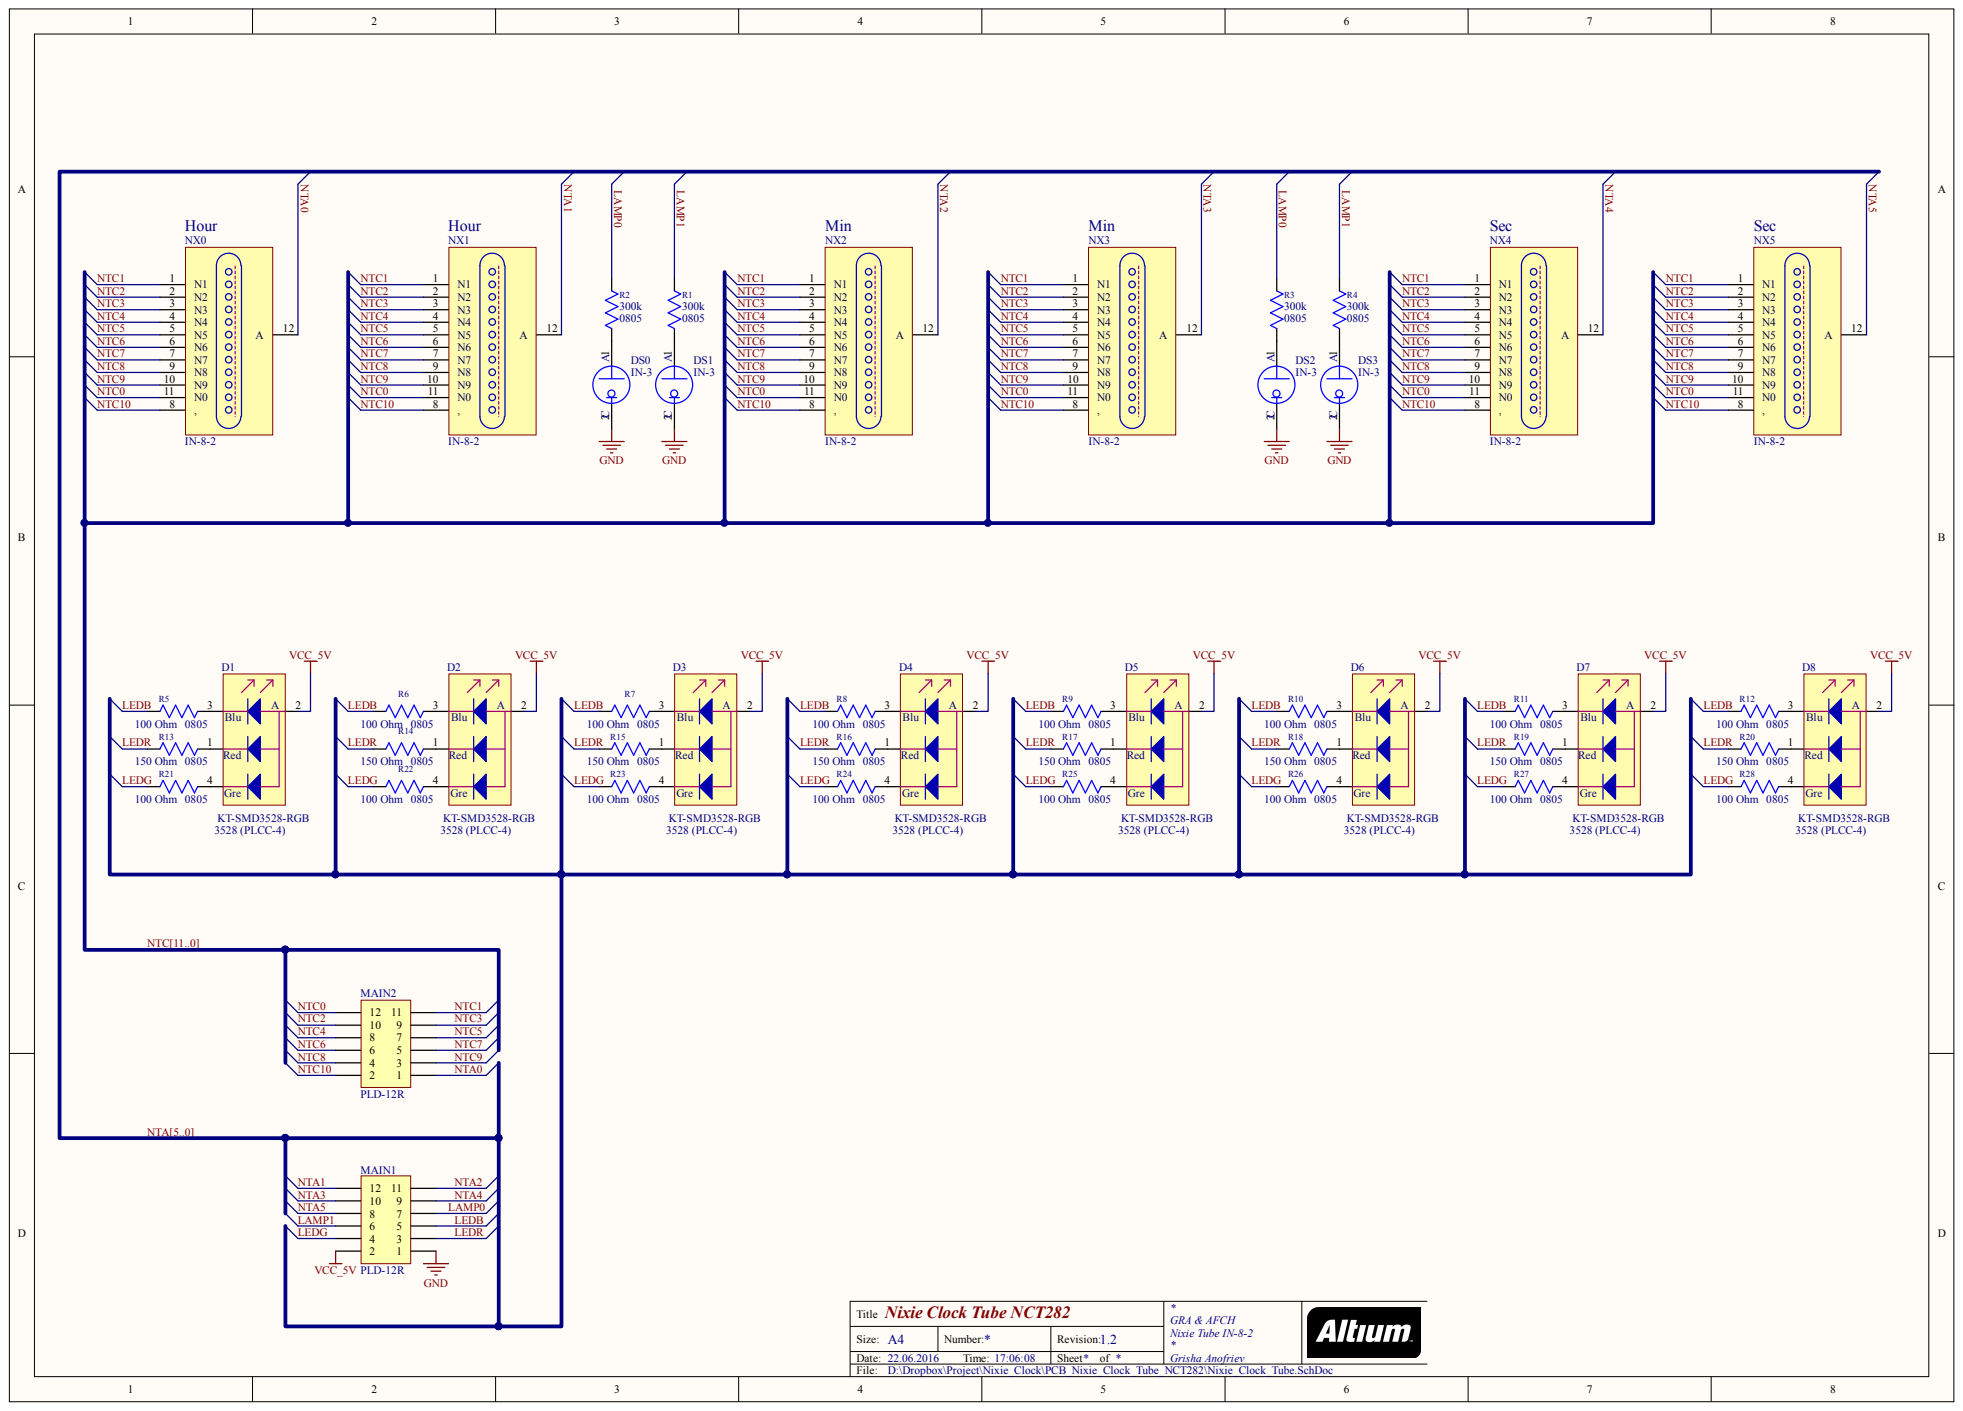
[picture p32: page 1]
