afch/NixieClock/Schemes/Previous Versions/Scheme Tubes Board - NCT566 v1.3.pdf

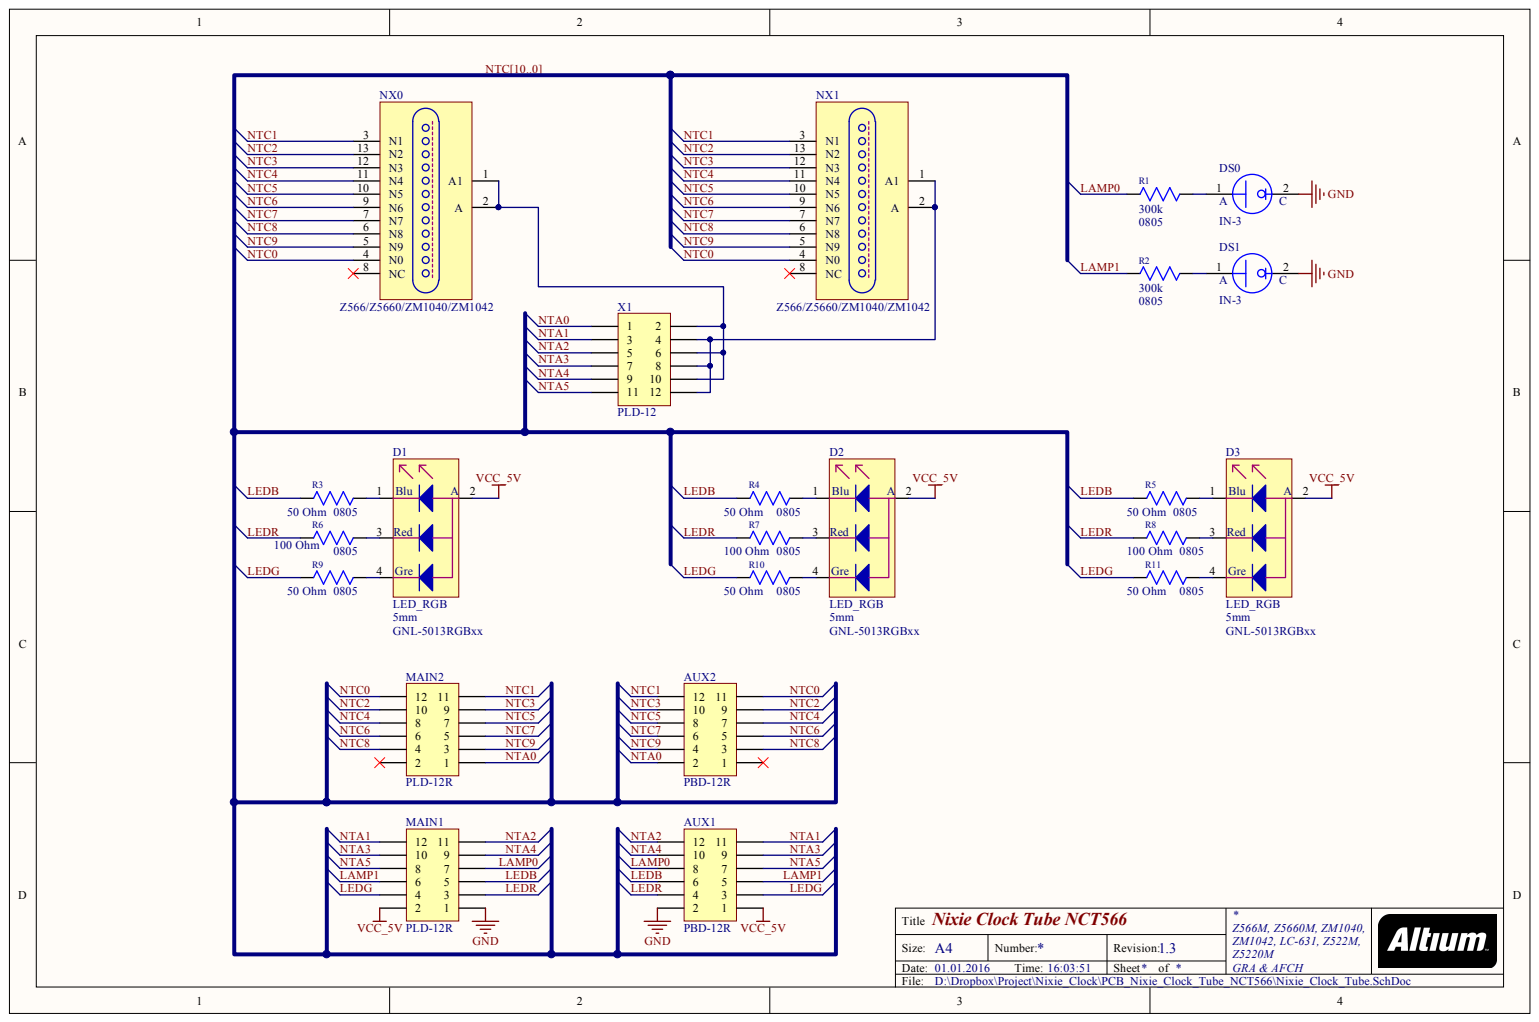
[picture p33: page 1]
