afch/NixieClock/Schemes/Previous Versions/Scheme Tubes Board - NCT573 v1.0.pdf

## Hour

## Hour

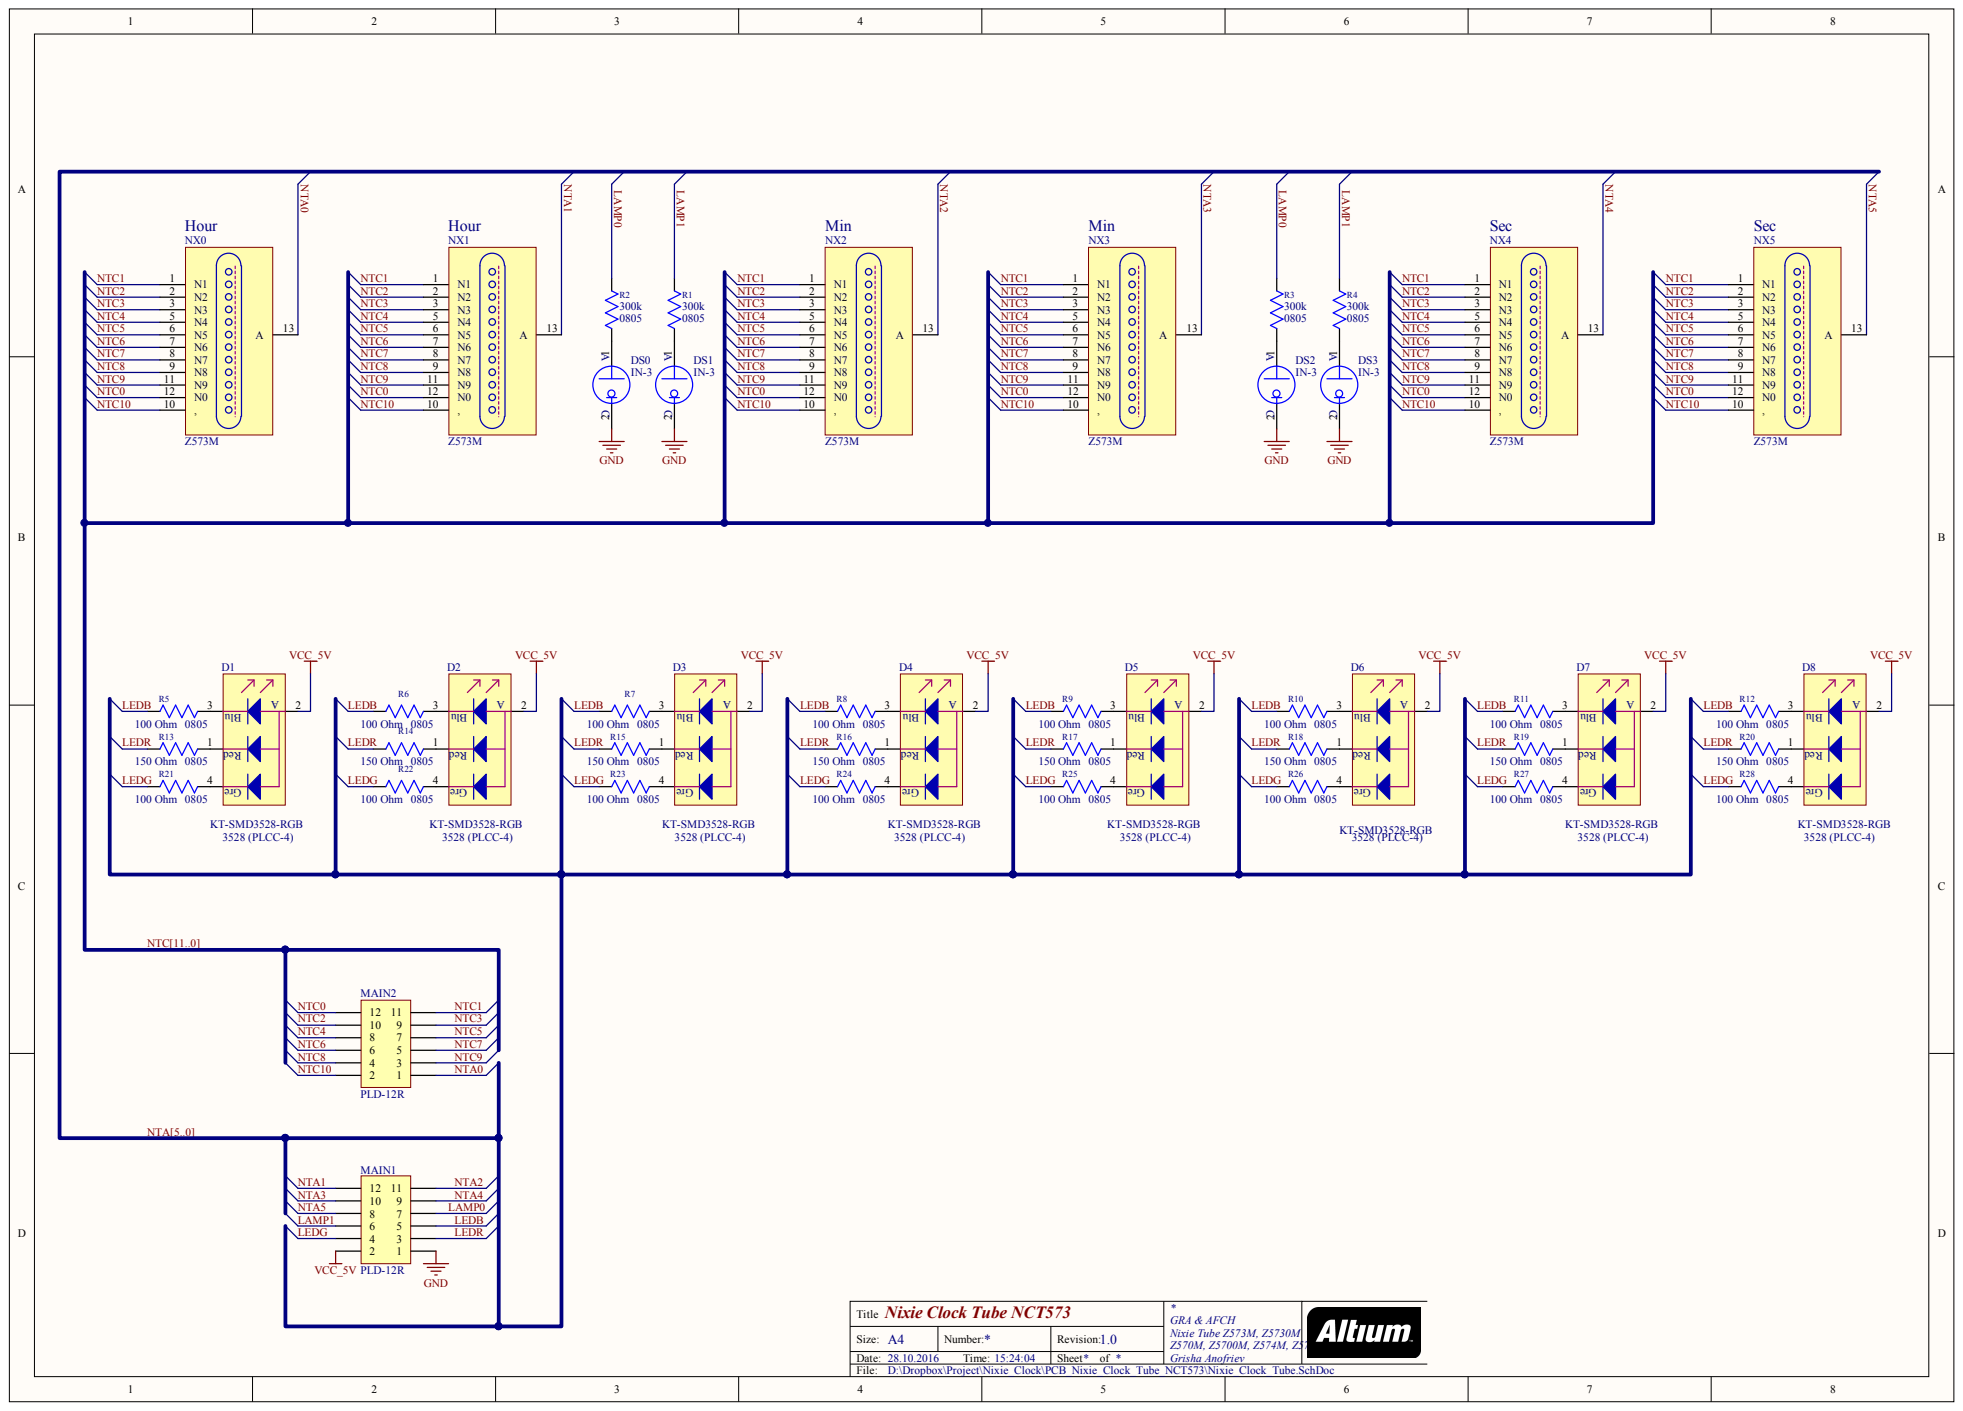
[picture p34: page 1]
