afch/NixieClock/(commit log)

2015-11-12 stable, 1st sound.
    1. Исправлена проблема с не выключением светододиодов долгим удержанием
    кнопки
    2. Добавлена возмжность проигрывать мелодии
    3. Пины-кнопки подогнаны под те что используються в собранных часах
    4. Добавлена библиотека software tone
    5. Отпускание любой кнопки приводит к писку
    [NixieClock.ino]
2015-11-14 v14112015
    fixed 12 hour mode
    added incrementValue and decrementValue functions it allows change value
    at one point in the code.
    fixed bug with 0 day and 0 month
    added 12 hour mode
    added saving in eeprom leads state and hours mode
    [NixieClock.ino]
2016-01-06 New schemes
    Clock scheme was update, added schemes for IN-14 and Z566M (and etc.)
    tubes.
2016-05-10 Updated to version 1.48
    RGB leds test bug fixed
    Leap year bug fixed
    Fixed: 29/02 bug
    [NixieClock.ino]
2016-07-12 ver 1.49
    Fixed menu switching bug
    [NixieClock.ino]
2016-07-16 ver 1.491
    * Added updateDateString function
    * Fixed PreZero - reduced time execution
    * reduced flickering in date and alarm modes
    [NixieClock.ino]
2016-10-02 Firmware ver 1.5
    Added LEDs color fixing ability.
    [NixieClock.ino]
2016-10-02 Manual for ver 1.5
    Added: Fixing LEDs color.
2016-10-08 USB driver added
2016-10-18 Ver 1.5.1
    Fixed: Date was not update after setting by user.
    Fixed: RGB color controls
    Update to Arduino IDE 1.6.12 (Time.h replaced to TimeLib.h)
    [NixieClock.ino]
2016-10-23 ver 1.5.2
    Fixed: changing modes while in edit mode.
    [NixieClock.ino]
2016-10-26 v1.5.3
    Slot Machine effect
2017-03-17 Firmware for NCT818 tubes board added
    Firmware for NCT818 tubes board added
2017-05-08 v1.03.1
    Slot machine effect added.
2017-05-08 v.1.03.1
    Slote machine effect added.
2017-05-10 Antipoisoning slot machine effect
2017-06-01 v 1.032
    Added time sync with RTC for NCT318 board
2018-01-12 v1.63
    Added: LEDs brightness adjustments.
    //1.62 04/11/2017
    //Added: Modes changer settings in main menu
    //1.61
    //Added: temperature adjustemnts
2018-05-03 NCM109 8 tubes
2018-06-29 4xx blink bug fixed
    [doIndication109.ino]
2018-08-04 v1.5
    //Added: Dual Date Format
    //Fixed: temp reading speed
    //Fixed: RGB LEDs color reading from EEPROM
    //Fixed: dot mixed up (Driver v1.2 is required)
    [NixieClock_NCM109.ino, NixieClock_NCM109_FOR_NCT3XX_Series.ino, doIndication109.h, doIndication109.ino, doIndication318.ino]
2018-09-11 1K Revision
    The service life of the tubes is increased.
2020-01-24 Added DS3231 internal temperature self test
    Added DS3231 internal temperature sensor self test: 5 beeps if fail.
    [NixieClock_NCM109.ino, NixieClock_NCM109_FOR_NCT3XX_1K.ino, NixieClock_NCM109_FOR_NCT8xx_1K.ino]
2020-04-08 v.1.66
    Fixed: Seconds setting bug
    [NixieClock_NCM109_FOR_NCT3XX_8_Tubes.ino]
2021-03-23 v.1.67
    //1.67 22.12.2020
    // The driver has been changed to support BOTH HV5122 and HV 5222 (switching using resistor R5222 Arduino pin No. 8)
    //SPI initialization moved to SPI_Init()
    //1.66 08.04.2020
    //Fixed: Seconds s
    [NixieClock_NCM109_FOR_NCT8xx_1K.ino, doIndication818.h, doIndication818.ino]
2021-04-23 Alternative firmware countdown timer
    Alternative firmware countdown timer.
2022-02-09 v.1.64
    Fixed: Seconds settings bug
    [NixieClock_NCM109_FOR_NCT3XX_8_Tubes.ino]
2022-02-09 v.1.64
    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
    [NixieClock_NCM109_FOR_NCT3XX_8_Tubes.ino]
2022-02-18 v1.69
    Fixed: min value bug
    [NixieClock_NCM109_FOR_NCT8xx_1K.ino, NixieClock_NCM109_FOR_NCT8xx_1K_US_MOD.ino]
2022-05-09 v.1.70
    Fixed: year value bug
    [NixieClock_NCM109_FOR_NCT8xx_1K.ino, NixieClock_NCM109_FOR_NCT8xx_1K_US_MOD.ino]
2022-08-18 1.57
    //1.57 18.08.2022
    //Fixed: RV-3028-C7 init
    [NixieClock_NCM109.ino]
2023-03-21 v1.58
    Fixed: DS18b20 zeros bug
    [NixieClock_NCM109.ino, doIndication109.h, doIndication109.ino]
2023-05-01 v1.55
    HV5222 support
    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
    [NixieClock_NCM109_FOR_NCT3XX_1K.ino, doIndication318_1K.h, doIndication318_1K.ino]
2023-09-05 v1.71
    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
    [NixieClock_NCM109_FOR_NCT8xx_1K_US_MOD.ino]
2024-02-26 Drivers update
